NoeMrct/terrarium_thermostat/docs/depannage.md

# Dépannage — arbre de décision

Partir du symptôme, suivre les flèches. Les commandes série (`help`, `status`,
`scan`, `sante`, `journal`) se tapent dans le moniteur série de l'IDE Arduino à
115200 bauds, ou dans `arduino-cli monitor`.

```mermaid
flowchart TD
  A[Symptôme] --> B{L'écran s'allume ?}
  B -- non --> B1{LED rouge de la carte allumée ?}
  B1 -- non --> B2[Pas d'alimentation : LM2596 à 5,00 V ? fusible ? masse commune ?]
  B1 -- oui --> B3[OLED : SDA 21 / SCL 22 inversés ? adresse 0x3C ? tester `scan` i2c]
  B -- oui --> C{Que dit l'écran ?}
  C -- "AP" --> C1[Pas de Wi-Fi : réseau terrarium-config-XXXXXX, la page s'ouvre seule sinon 192.168.4.1 ; ou `wifi ssid mdp` en série, qui essaie tout de suite]
  C -- "! SONDE" --> D
  C -- "! SURCHAUFFE" --> E
  C -- "! FIGEE" --> F
  C -- "adresse IP, températures" --> G{Le problème est à distance ?}
  G -- oui --> H
  G -- non --> I[Comportement thermique : voir plus bas]
```

## D — Défaut SONDE, ou « aucune sonde détectée »

1. `scan` : combien de sondes ? Si 0, c'est le câblage 1-Wire, pas le logiciel.
2. Résistance **4,7 kΩ entre data et 3,3 V** présente ? Mesurée à 4,7 (calibre 20 k) ?
3. Data sur **GPIO4** du module lui-même — pas une borne de carte d'accueil
   non vérifiée. Mesurer picot ↔ borne à l'ohmmètre : attendu ≈ 0 Ω. (Une carte
   d'accueil a déjà montré 900 kΩ.)
4. Masse commune entre la sonde et la carte ; rouge sur 3,3 V (ou 5 V : tout
   DS18B20 accepte 3 à 5,5 V).
5. Fils Dupont : chacun testé à l'ohmmètre ; les sertissages bon marché font
   des liaisons à haute résistance.
6. Si une seule sonde : la lier aux deux zones en attendant n'est pas possible ;
   la zone sans sonde reste en défaut, c'est voulu.
7. Deux sondes détectées mais la zone reste en défaut : `identifier <zone>` (puis
   serrer sa sonde dans la main) ou `lier <index> <zone>`, puis `reset`.
8. Sonde remplacée : l'ancienne est « absente du bus » et la nouvelle n'est pas
   liée d'office (elle pourrait être celle d'une autre plaque). `identifier
   <zone>` la lie sans ambiguïté.

## E — Défaut SURCHAUFFE

- La sonde a lu plus que la coupure maximale. Si la température réelle (IR) est
  normale : sonde mal placée (contre un point très chaud), ou coupure maximale
  trop basse par rapport à la consigne.
- Si la température réelle est vraiment haute : tapis trop puissant pour la
  surface, ou MOSFET resté passant → couper le 12 V, mesurer la grille (doit être
  à 0 V tapis coupé), remplacer le MOSFET.

## F — Défaut FIGEE (sonde bloquée)

La sonde renvoie strictement la même valeur pendant des minutes. Souvent un fil
data intermittent (valeur en cache du capteur) ou une sonde contrefaite. Secouer
doucement le câble en regardant `status` : si la valeur bouge, c'est le fil.

## G — Défaut CHAUFFE SANS EFFET (sondes inversées)

La chauffe d'une zone a fait monter la sonde d'une autre zone, pas la sienne :
les sondes sont presque toujours inversées (ou posées sur la mauvaise plaque).
Les deux zones sont coupées.

1. `identifier 1`, puis serrer dans la main la sonde posée sur la plaque 1 ;
   pareil pour la zone 2. Ou intervertir les sondes physiquement.
2. `reset` pour lever les défauts.
3. `essai 1` puis `essai 2` : chaque zone chauffe seule et le socle confirme que
   c'est bien sa sonde qui monte.

## H — Problèmes à distance (application)

| Ce que montre l'application | Cause probable | Quoi faire |
|---|---|---|
| « non connecté » / erreur d'adresse | URL du broker fausse, pas en `wss://` | Tester la connexion ; adresse `wss://…:8884/mqtt` chez HiveMQ |
| « connexion refusée : identifiants » | mauvais compte broker | Compte de l'application (`appli`), pas celui du socle |
| socle **hors ligne** | socle sans Wi-Fi ou sans MQTT | Bas de l'écran (WIFI --, code MQTT, AP config) ou LED bleue (éclair par seconde : pas de Wi-Fi ; double éclair : MQTT refusé) ; `reseau` en série donne la raison ; `mqtt` réglé ? TLS 8883 ? |
| socle **silencieux** | en ligne mais ne publie plus | Wi-Fi faible (voir Santé du socle), redémarrer |
| « le socle n'a pas répondu » | commande sans réponse | identifiant du socle exact (`terraXXXXXX`) ; préfixe des sujets identique des deux côtés |
| « jeton invalide » | code d'appairage faux | 24 caractères, majuscules ; `jeton` en série |
| « mets à jour l'application » | socle plus récent que l'app | Recharger l'application (bouton « Recharger ») |
| « firmware à mettre à jour » / carte Mise à jour du firmware | socle en retard sur la dernière release | Bouton « Mettre à jour » : le socle télécharge et redémarre ; état `retour arrière` = la nouvelle image a planté, l'ancienne tourne |
| « hote non autorise » à la mise à jour | URL hors des releases du dépôt | Donner une version (`3.4.0`) plutôt qu'une URL ; un fork adapte `config.h` |
| `terraXXXXXX.local` injoignable | réseau sans mDNS, ou cookies bloqués en `http://` | Adresse IP (dans la santé du socle : `ip`) ; autoriser les cookies pour l'adresse locale |

## I — Comportement thermique

- **N'atteint pas la consigne** : alimentation déclarée trop faible (une seule
  zone à la fois), tapis sous-dimensionné, pièce froide. Regarder `demande` :
  100 % en permanence = manque de puissance.
- **Oscille** : lancer l'autotune une fois stable ; sinon bande plus large.
- **Dérive signalée** : couvercle ouvert, pièce froide, tapis vieillissant.
- **Chauffe sans effet** (alerte) : le tapis chauffe et rien ne monte. Fil de
  tapis coupé, bilame ouvert (plaque > 70 °C ?), fusible. Avec un INA219, la
  mesure de courant le dit directement. Si c'est la sonde d'une autre zone qui
  monte, c'est un défaut : voir G.
- **Trop chaud** : la zone dépasse sa consigne sans chauffer. La pièce ou une
  lampe chauffe plus que voulu : le socle ne peut que couper, c'est déjà fait.

## Après un redémarrage inattendu

`sante` affiche la cause (`PANIQUE`, `WATCHDOG`, `CHUTE D'ALIMENTATION`) et le
résumé du coredump ; `test usine` vérifie en une fois écran, sondes, mémoire,
partitions et Wi-Fi. `CHUTE D'ALIMENTATION` = le 5 V s'est effondré : LM2596,
câble, ou tapis qui tire sur le 12 V au démarrage. `PANIQUE` = bug : joindre le
fichier `/api/coredump` à un rapport. Une mise à jour fraîche qui plante est
annulée toute seule : le socle revient à la version d'avant et le dit.

Trois redémarrages anormaux de suite déclenchent une alerte : à ce stade, c'est
l'alimentation ou le câblage qu'il faut revoir avant toute chose. Après une
coupure de courant, une alerte donne sa durée (en fourchette) dès que l'heure
est revenue.
