NoeMrct/terrarium_thermostat/PROTOCOLE.md

# Protocole de pilotage à distance

Ce document décrit comment une application web ou mobile parle au socle
chauffant à travers un broker MQTT, depuis n'importe où.

---

## 1. Le principe

Le socle n'est pas joignable depuis Internet : il est derrière une box, sans
adresse publique. Il ne reçoit donc pas de connexions — **c'est lui qui se
connecte** à un broker MQTT, et il y reste attaché en permanence.

L'application fait de même. Le broker sert de point de rendez-vous entre les
deux, et personne n'a besoin d'ouvrir de port.

```
   socle ───┐                        ┌─── application web
            ├──►  broker MQTT  ◄─────┤
   socle ───┘   (rendez-vous)        └─── application mobile
```

**L'historique reste sur le socle.** Le broker ne transporte que l'état courant,
les événements et les commandes. C'est ce choix qui rend l'ensemble tenable sur
un hébergement gratuit : quelques kilo-octets par appareil et par jour, au lieu
de plusieurs méga-octets si l'on remontait chaque point de mesure.

---

## 2. Le code d'appairage

À son tout premier démarrage, le socle tire au sort un code de 24 caractères
avec le générateur aléatoire matériel de l'ESP32, l'enregistre, et **l'affiche
en grand à l'écran pendant vingt secondes**. Il est aussi écrit sur le port
série.

```
Code d'appairage : K7M2QX-4TBW9H-RPFZ3N-XCVJ8D
```

Ce code est retrouvable à tout moment :

- commande série `jeton` (il se réaffiche aussi à l'écran) ;
- onglet Réseau de l'interface web locale ;
- `jeton nouveau` en génère un autre — les applications déjà appairées devront
  alors être réappairées.

Il vaut **preuve de propriété** : quiconque le possède peut piloter le socle. Il
n'est jamais transmis en clair sur le réseau tant que MQTT est chiffré.

Pour un produit, l'imprimer sous forme de QR code collé sous l'appareil évite à
l'acheteur d'avoir à le recopier.

---

## 3. Configuration du socle

```
mqtt broker.exemple.fr 8883 utilisateur motdepasse
mqtt tls on
redemarrer
```

Vérifier ensuite avec `reseau`. Le socle publie son état dès qu'il change (au
plus toutes les 2 s, au moins toutes les 60 s) et se reconnecte tout seul. Avec
le serveur Terrariums (`serveur/`), `outils/provisionner.js` crée le compte du
socle et passe cette commande à sa place.

Tout cela se règle aussi depuis l'onglet Réseau de l'interface web.

---

## 4. Les sujets MQTT

Avec un préfixe `terrarium` et un identifiant d'appareil `terraA1B2C3` :

| Sujet | Sens | Contenu |
|---|---|---|
| `terrarium/terraA1B2C3/statut` | socle → app | `en ligne` / `hors ligne` (persistant) |
| `terrarium/terraA1B2C3/zone1/etat` | socle → app | JSON d'état (persistant), **dès que quelque chose change** — au plus toutes les 2 s — et de toute façon toutes les 60 s ; depuis la 3.5, avec `autotune`, `derive` et `trop_chaud` (`"0"`/`"1"`) |
| `terrarium/terraA1B2C3/zone2/etat` | socle → app | idem |
| `terrarium/terraA1B2C3/sante` | socle → app | JSON de santé (persistant), toutes les 60 s : `proto`, `version`, `uptime`, `rssi`, `heap`, `heapMin`, `blocMax`, `reset`, `otaEnAttente`, `signatureOta`, `hote` (`terraA1B2C3.local`), `ip`, `maj` (dernière mise à jour tirée : `etape`, `version`, `detail` — absent si aucune), `plantage` (si un coredump existe), `courantA`/`energieWh` (avec INA219), `mqtt` (état de la connexion au broker, en clair) et `webProtege` (l'interface locale demande un mot de passe), depuis la 3.5 |
| `terrarium/terraA1B2C3/rapport` | socle → app | rapport quotidien en texte (persistant), à l'heure choisie, si le rapport est activé — depuis la 3.5 |
| `terrarium/terraA1B2C3/maj` | socle → app | progression d'une mise à jour tirée (non persistant) : `etat` (`telechargement`, `redemarrage`, `erreur`), `pct`, `detail`, `version` |
| `terrarium/terraA1B2C3/cmd` | app → socle | requête JSON (l'application l'envoie en QoS 1) |
| `terrarium/terraA1B2C3/reponse` | socle → app | réponse JSON |
| `terrarium/serveur` | serveur → app | **serveur Terrariums seulement** : annonce retenue `{"serveur":"terrariums","version":…,"push":…}`, lisible par tout compte, que lui seul écrit. Un socle n'y touche jamais ; un broker nu n'a pas ce sujet, et l'application n'y attend rien |

Le sujet `statut` utilise le **testament** MQTT : si le socle disparaît
brutalement (coupure de courant, WiFi perdu), le broker publie lui-même
`hors ligne`. L'application le sait en quelques secondes, sans rien interroger.
Un socle `en ligne` qui n'a rien publié depuis plus de deux minutes est montré
**silencieux** par l'application : le testament ne distingue pas un socle vivant
d'un socle coincé.

### Version du protocole

Le socle annonce `proto` (dans `sante`, dans la réponse `etat` et `version`).
Cette page décrit la **version 4** (firmware 3.5) : les commandes modifiantes
voyagent signées, sans le code d'appairage en clair (voir « Commandes
signées » ci-dessous), et l'application fait à distance ce que seule la page
locale savait faire (sondes, essai, calibration, rapport, journal, résumés
journaliers, sauvegarde, surveillance — dernières lignes du tableau des
actions). La version 3 (3.4) a ajouté l'action `maj`, le sujet
`maj` et les champs `hote`, `ip`, `maj` de la santé. La version 2
(3.3) n'avait pas de mise à jour tirée ; la version 1 (3.0 à 3.2) n'avait ni
`sante`, ni `proto`, ni le rejeu des commandes. Un changement que
l'application ne saurait pas interpréter incrémente ce numéro ; l'application
affiche « mets à jour l'application » ou « firmware à mettre à jour » selon le
cas. `protocole.schema.json` (JSON Schema) décrit formellement chaque message,
et `outils/test-protocole.js` vérifie que tout ce que le socle émet s'y conforme.

---

## 5. Le canal de commande

Une seule paire de sujets transporte tout, en JSON. La surface exposée est celle
de l'interface web locale.

### Requête

```json
{ "req": "42", "action": "zone", "jeton": "K7M2QX...", "z": 0, "jour": 32.5 }
```

- `req` : identifiant libre (23 caractères au plus), recopié dans la réponse pour
  l'apparier. **Une requête déjà traitée reçoit à nouveau sa réponse sans être
  rejouée** : le socle garde ses huit dernières réponses courtes. C'est ce qui
  permet d'envoyer les commandes en QoS 1 (livraison garantie, doublons
  possibles) sans qu'un `redemarrer` redémarre deux fois.
- `action` : voir le tableau ci-dessous.
- `jeton` : exigé pour toute action modifiante d'un socle d'avant le protocole
  4. Les actions de lecture s'en passent. Un socle au protocole 4 l'accepte
  encore, mais l'application ne l'envoie plus : elle signe.

### Commandes signées (protocole 4)

Le code d'appairage ne circule plus sur le broker. La commande est sérialisée
telle quelle, horodatée, puis mise dans une enveloppe avec sa signature :

```json
{ "c": "{\"req\":\"42\",\"action\":\"zone\",\"z\":0,\"jour\":32.5,\"ts\":1794600000}",
  "sig": "<HMAC-SHA256 de c, clé = code d'appairage, 64 chiffres hexadécimaux minuscules>" }
```

- La signature porte sur les octets UTF-8 exacts de `c` : rien à
  canonicaliser, le socle vérifie puis relit `c` comme une requête ordinaire.
- `ts` (secondes Unix) : un socle à l'heure refuse une commande signée qui
  s'en écarte de plus de 5 minutes (`commande perimee`) ; c'est ce qui borne le
  rejeu d'une commande captée, avec la mémoire des huit dernières requêtes.
- Signature fausse : `{"ok":false,"erreur":"signature invalide"}` (avec le
  `req` de la commande), journalisé comme un code refusé.
- En JavaScript : `crypto.subtle.importKey('raw', code, {name: 'HMAC', hash:
  'SHA-256'}, …)` puis `sign('HMAC', clé, c)` ; en Node : `crypto.createHmac`.

### Réponse

```json
{ "req": "42", "ok": true }
{ "req": "42", "ok": false, "erreur": "Consigne de jour hors 10-45 C" }
```

### Actions disponibles

| Action | Jeton | Paramètres | Effet |
|---|---|---|---|
| `etat` | non | — | Températures, consignes du moment **et de référence**, demande, charge, défauts, autotune, dérive, horaires, temps de fonctionnement, `proto` et `sante` |
| `version` | non | — | Version du firmware, date de compilation, `proto` |
| `stats` | non | — | Min / max / moyenne sur 24 h, temps hors plage, énergie, compteurs de défauts |
| `historique` | non | `heures` (1-400, défaut 24), `max` (1-200, défaut 120) | Points de courbe, échantillonnés |
| `zone` | **oui** | `z`, et `nom`, `jour`, `nuit`, `bande`, `ki`, `max`, `offset`, `rampe`, `debutJour`, `debutNuit`, `deriveSeuil`, `deriveMin`, `inefficaceMin`, `inefficaceDelta`, `chuteSeuil`, `chuteSecondes` | Modifie une zone |
| `globaux` | **oui** | aucun (lecture), ou `amperes`, `watts`, `volts`, `entretienMin`, `ecranVeilleMin`, `saisonActive`, `saisonDelta`, `saisonDescenteJ`, `saisonPlateauJ`, `saisonRemonteeJ` ; depuis le protocole 4 : `prixKwh` (0-5 €), `rapportActif`, `rapportMinutes` (heure d'envoi, 0-1439), `ledEteinte`, `ecranNuit` (0 atténué, 1 normal, 2 éteint), `soleilActif`, `soleilDecalageMin` (-180-180), `latitude` (-65-65), `longitude`, `zonePrioritaire` (0 aucune, 1 ou 2) | Lit ou modifie les réglages de l'appareil |
| `reset` | **oui** | — | Lève les défauts verrouillés |
| `entretien` | **oui** | `minutes` (0-240, 0 annule) | Coupe le chauffage temporairement, reprise automatique |
| `autotune` | **oui** | `z` | Lance la calibration automatique |
| `stop-autotune` | **oui** | `z` | L'interrompt |
| `effacer-historique` | **oui** | — | Vide les courbes |
| `alim` | **oui** | `amperes`, `watts` | Raccourci historique de `globaux` |
| `redemarrer` | **oui** | — | Redémarre le socle |
| `maj` | **oui** | `version` (`X.Y.Z`, release GitHub) ou `url` (`https://`, releases du dépôt seulement), `forcer` | Le socle télécharge et installe l'image, publie sa progression sur `maj`, redémarre ; la réponse `{"ok":true,"maj":"telechargement"}` part avant le téléchargement. Refus : `deja en X.Y.Z` (sans `forcer`), `hote non autorise`, `hors ligne` |
| `sondes` | **oui** | `relire` (relit le bus 1-Wire d'abord) | `"sondes":{…}` : les sondes du bus (`rom`, `temp`, `zone` comptée depuis 0, -1 si libre), `liaisons` de chaque zone (`rom`, `presente`), `identification` en cours, `resultat` de la dernière |
| `lier` | **oui** | `z`, `rom` (16 chiffres hexadécimaux) | Lie une sonde présente à une zone (et la retire d'une autre) ; `message` |
| `identifier` / `stop-identifier` | **oui** | `z` / — | Lance l'assistant (chauffe suspendue, 2 min au plus : la sonde qu'on serre dans la main se lie à la zone) ou l'annule ; l'avancement se lit avec `sondes` |
| `essai` / `stop-essai` | **oui** | `z` / — | Essai de chauffe d'une zone seule ; sans `z`, `"essai":{"zone","restantS","resultat"}` (`zone` comptée depuis 1, 0 : aucun essai) |
| `calibrer` | **oui** | — | Aligne la zone 2 sur la zone 1 (sondes côte à côte) ; `message` ou `erreur` |
| `rapport` | **oui** | `envoyer` | Le rapport du jour (`texte`), ou son envoi immédiat vers l'adresse des alertes |
| `jours` | **oui** | `n` (1-400, défaut 7) | `"jours":{"prixKwh","jours":[…]}` : résumés journaliers du plus récent au plus ancien, autant qu'un message en tient (une trentaine) ; la page locale les donne tous |
| `journal` | **oui** | — | La fin du journal (`texte`, 5000 caractères au plus) |
| `sauvegarde` | **oui** | — | `"sauvegarde":{…}` : la configuration (zones, réglages, sondes, réseau non secret), **sans les adresses d'alerte et de heartbeat** |
| `restaurer` | **oui** | `sauvegarde` (objet) | Réapplique une sauvegarde, tout ou rien ; les adresses absentes gardent celles du socle ; `message` |
| `reseau` | **oui** | aucun (lecture), ou `urlAlertes`, `urlHeartbeat` (`http(s)://`, 160 car.), `heartbeatMinutes` (1-1440), `formatAlertes` (0 JSON, 1 texte) | La surveillance seulement. Réponse : `ssid`, `ssid2`, `alertes` et `heartbeat` (**l'hôte seul** des adresses, vide si aucune), `heartbeatMinutes`, `formatAlertes`. Tout identifiant Wi-Fi (`ssid`, `ssid2`, `wifiPass`, `wifiPass2`) est refusé : le Wi-Fi se règle sur la page locale |

Les horaires (`debutJour`, `debutNuit`) sont en minutes depuis minuit :
`8:00` s'écrit `480`.

### Format de l'historique

Un message MQTT n'a pas de tampon extensible, contrairement à une réponse HTTP
diffusée par morceaux. Les points sont donc renvoyés **compactés**, sous forme de
tableaux plutôt que d'objets — une clé par valeur aurait triplé la taille :

```json
{
  "req": "42", "ok": true,
  "format": ["epoch", "t1", "consigne1", "t2", "consigne2"],
  "unite": "centiemes de degre",
  "pas": 12, "heures": 24, "n": 120,
  "points": [[1757520000, 3205, 3200, 2790, 2800], [1757520720, null, 3200, 2788, 2800]]
}
```

`null` marque une mesure absente. `pas` dit combien de points d'origine sépare
deux points renvoyés. **L'historique complet reste sur le socle** : ce canal n'en
transporte qu'un échantillonnage, à la demande.

### Validation

Les réglages passent **exactement les mêmes contrôles** que par l'interface
web ou la console série : la validation vit dans le cœur de régulation, elle
n'est pas réécrite pour chaque interface. Une application ne peut donc pas
placer le socle dans un état que l'interface locale refuserait.

---

## 6. Exemple d'application

```js
import mqtt from 'mqtt';

const ID = 'terraA1B2C3';
const JETON = 'K7M2QX...';
const base = `terrarium/${ID}`;

const client = mqtt.connect('wss://broker.exemple.fr:8884/mqtt', {
  username: 'app', password: '…'
});

client.on('connect', () => {
  // Attention : le joker occupe un niveau entier, « zone+/etat » est invalide.
  client.subscribe([`${base}/statut`, `${base}/+/etat`, `${base}/reponse`]);
});

client.on('message', (sujet, charge) => {
  if (sujet.endsWith('/statut')) {
    majPresence(charge.toString() === 'en ligne');
  } else if (sujet.endsWith('/etat')) {
    majZone(sujet, JSON.parse(charge));
  } else if (sujet.endsWith('/reponse')) {
    const r = JSON.parse(charge);
    (attentes[r.req] || (() => {}))(r);
    delete attentes[r.req];
  }
});

const attentes = {};
// Protocole 4 : la commande part signée, le code ne quitte pas l'application.
async function signer(c) {
  const enc = new TextEncoder();
  const cle = await crypto.subtle.importKey('raw', enc.encode(JETON), { name: 'HMAC', hash: 'SHA-256' }, false, ['sign']);
  const mac = new Uint8Array(await crypto.subtle.sign('HMAC', cle, enc.encode(c)));
  return Array.from(mac, x => x.toString(16).padStart(2, '0')).join('');
}

function commander(action, params = {}) {
  return new Promise(async (resoudre, rejeter) => {
    const req = String(Date.now());
    attentes[req] = r => (r.ok ? resoudre(r) : rejeter(new Error(r.erreur)));
    const c = JSON.stringify({ req, action, ts: Math.floor(Date.now() / 1000), ...params });
    client.publish(`${base}/cmd`, JSON.stringify({ c, sig: await signer(c) }));
    setTimeout(() => {
      if (attentes[req]) { delete attentes[req]; rejeter(new Error('pas de reponse')); }
    }, 8000);
  });
}

// Passer la zone 1 à 32,5 °C le jour
await commander('zone', { z: 0, jour: 32.5 });

// Douze heures de courbe, 60 points au plus
const h = await commander('historique', { heures: 12, max: 60 });
const releves = h.points.map(([t, t1, c1]) => ({
  date: new Date(t * 1000),
  temperature: t1 === null ? null : t1 / 100,
  consigne:    c1 === null ? null : c1 / 100
}));

// Déclarer une alimentation plus grosse
const g = await commander('globaux', { amperes: 5 });
console.log(`${g.zonesSimultanees} zone(s) peuvent chauffer en même temps`);
```

**Le délai d'attente n'est pas facultatif** : un socle hors ligne ne répond pas,
et l'application doit le présenter comme tel plutôt que de rester bloquée.

---

## 7. Sécurité

| Mécanisme | Ce qu'il protège |
|---|---|
| MQTT chiffré (TLS) | Personne ne lit ni ne modifie le trafic en chemin |
| Certificats vérifiés (activé d'usine) | Personne ne se fait passer pour ton broker |
| Identifiants par appareil sur le broker | Un socle compromis ne donne pas accès aux autres |
| Jeton exigé pour les actions modifiantes | Un broker mal cloisonné ne suffit pas à piloter un socle |
| Commandes signées et horodatées (protocole 4) | Qui lit le broker ne vole pas le code d'appairage ; il ne peut ni forger une commande ni en rejouer une ancienne |
| Aucun secret relu par le broker (protocole 4) | Ni mot de passe Wi-Fi (refusé dans `reseau`), ni adresse d'alerte ou de heartbeat (seul l'hôte revient, la sauvegarde les omet) : lire le broker ne donne pas de quoi entrer sur le réseau ni écrire dans tes notifications |
| Validation dans le cœur de régulation | Aucune commande ne peut créer un réglage dangereux |
| OTA réseau désactivée sans mot de passe | Personne sur le réseau local ne réécrit le firmware |
| Images signées (ECDSA P-256) exigées par `/api/maj` et par la mise à jour tirée quand une clé publique est compilée | Même avec le mot de passe de l'interface ou le jeton, pas de firmware étranger |
| Mise à jour tirée limitée aux releases du dépôt (HTTPS, certificat vérifié, redirections bornées aux serveurs de GitHub) | Un jeton volé ne fait pas charger un binaire hébergé ailleurs |
| Interface locale : connexion par défi/réponse, session `HttpOnly` 24 h, pause après cinq échecs | Le mot de passe ne circule pas, et ne se devine pas en boucle |
| Retour arrière automatique après une mise à jour | Une image qui plante ne prive pas le terrarium de régulation |
| Commandes rejouées sans effet | Un doublon livré par le broker (QoS 1) n'agit pas deux fois |

**À faire côté broker** : un compte par appareil, avec des droits limités à ses
propres sujets. Sans ce cloisonnement, un appareil compromis pourrait écouter et
commander tous les autres — le jeton limite les dégâts, mais ne remplace pas un
cloisonnement correct.

**Ce que le jeton ne protège pas** : les actions de lecture (`etat`, `version`,
`stats`, `historique`) s'en passent délibérément, pour qu'un tableau de bord de
supervision puisse afficher l'état sans détenir de quoi modifier quoi que ce
soit. Quiconque peut s'abonner aux sujets du socle voit donc ses températures.
Si cela pose problème, c'est au cloisonnement du broker de le régler.

---

## 8. Ce que le socle continue de faire sans réseau

C'est le point le plus important pour un produit dont dépend un animal vivant.

Broker injoignable, WiFi coupé, serveur éteint : **la régulation continue à
l'identique**. Les consignes, le cycle jour/nuit, les diagnostics, les coupures
de sécurité et l'historique fonctionnent en local. L'écran affiche tout, la
console série pilote tout, et l'interface web reste accessible sur le réseau
local.

Le réseau n'ajoute que la commodité : accès de loin, alertes, courbes sur le
téléphone. Il ne conditionne jamais la sécurité de l'animal, et aucune évolution
future ne doit changer cela.
