NoeMrct/terrarium_thermostat/outils/references-visuelles/desktop-sombre-appareil.png

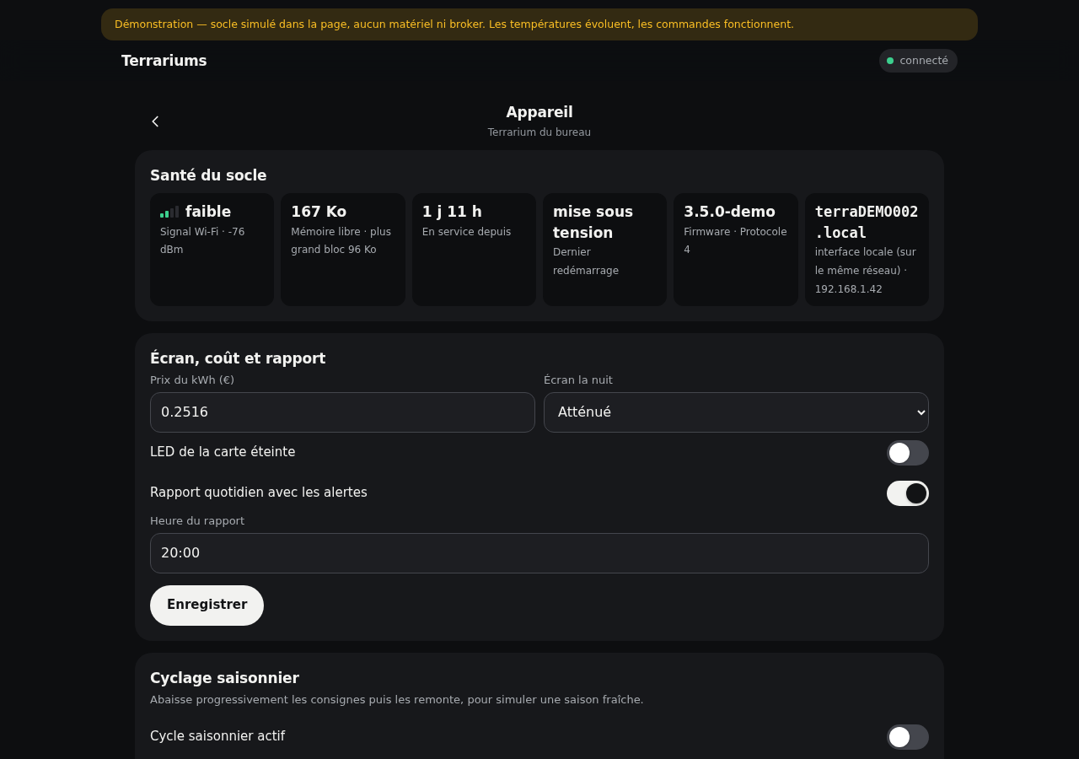
outils/references-visuelles/desktop-sombre-appareil.png
