NoeMrct/terrarium_thermostat/outils/references-visuelles/desktop-sombre-bienvenue.png

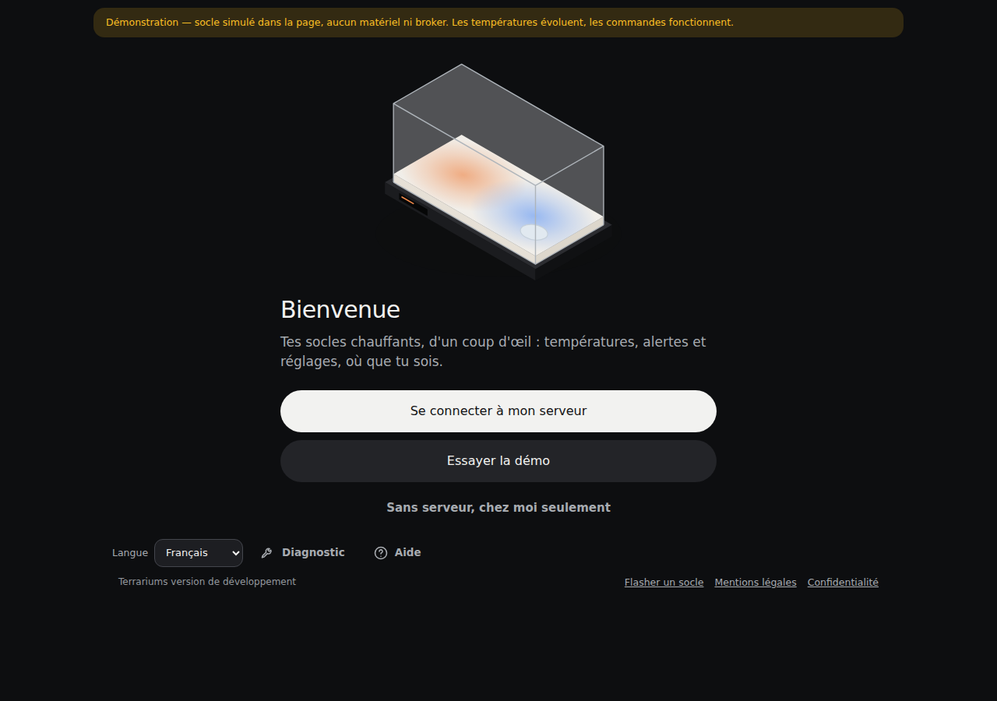
outils/references-visuelles/desktop-sombre-bienvenue.png
