NoeMrct/terrarium_thermostat/outils/references-visuelles/desktop-sombre-courbes.png

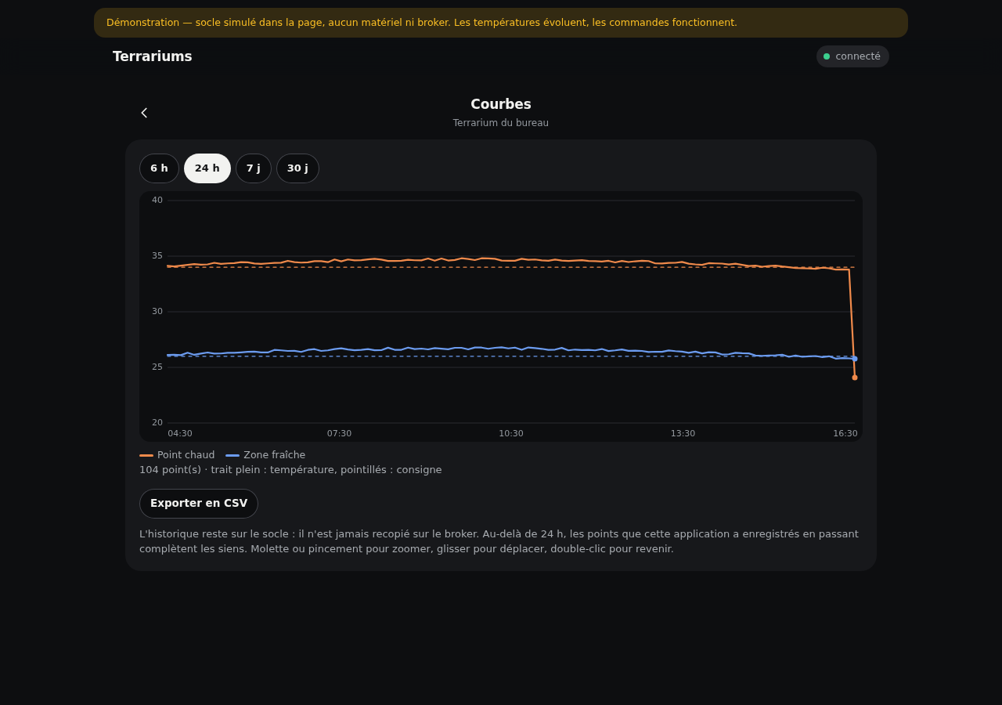
outils/references-visuelles/desktop-sombre-courbes.png
