NoeMrct/terrarium_thermostat/outils/references-visuelles/desktop-sombre-etat.png

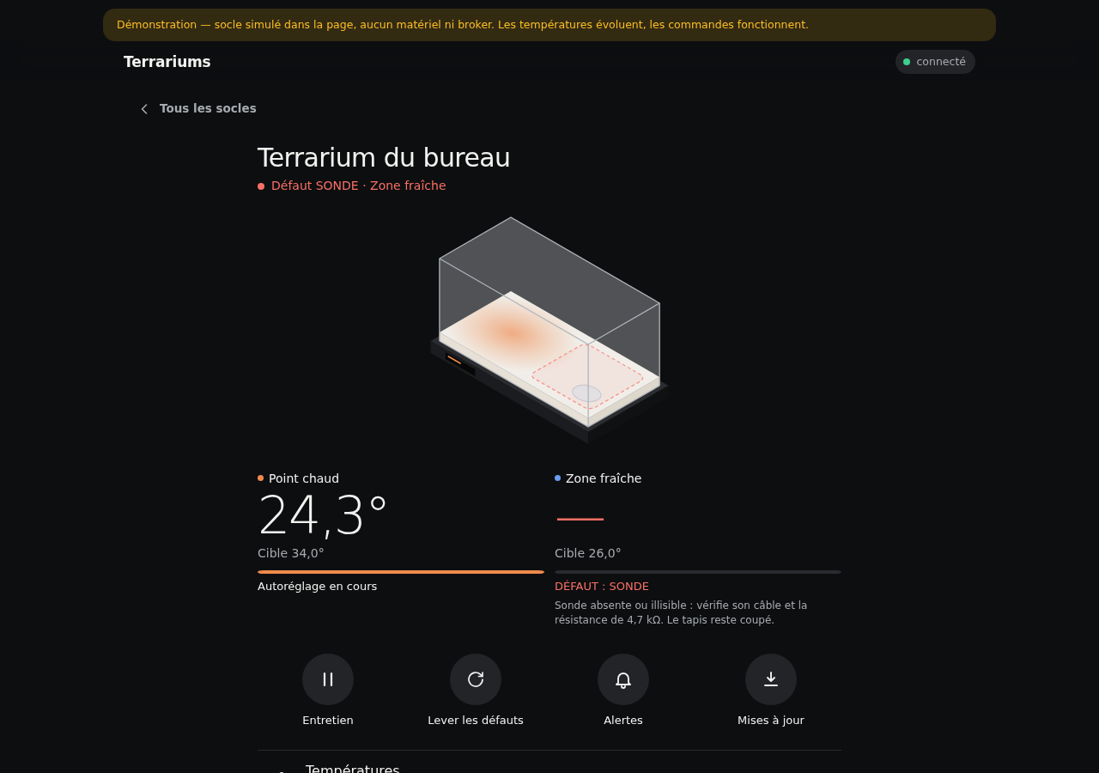
outils/references-visuelles/desktop-sombre-etat.png
