NoeMrct/terrarium_thermostat/outils/references-visuelles/desktop-sombre-liste.png

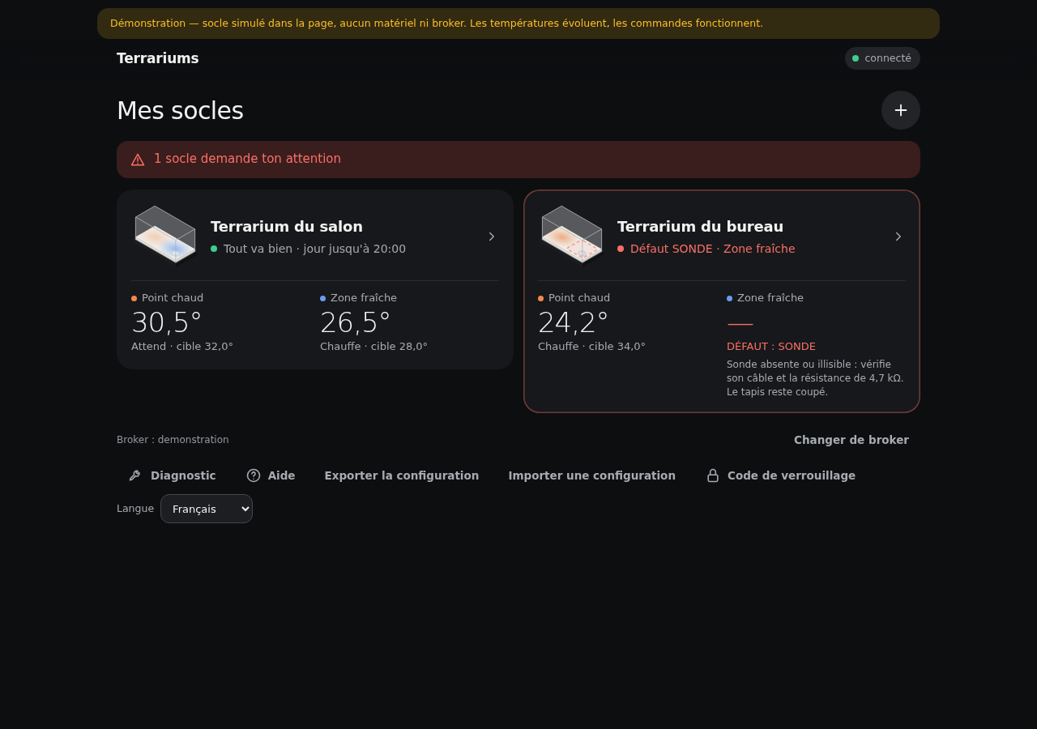
outils/references-visuelles/desktop-sombre-liste.png
