NoeMrct/terrarium_thermostat/outils/references-visuelles/desktop-sombre-reglages.png

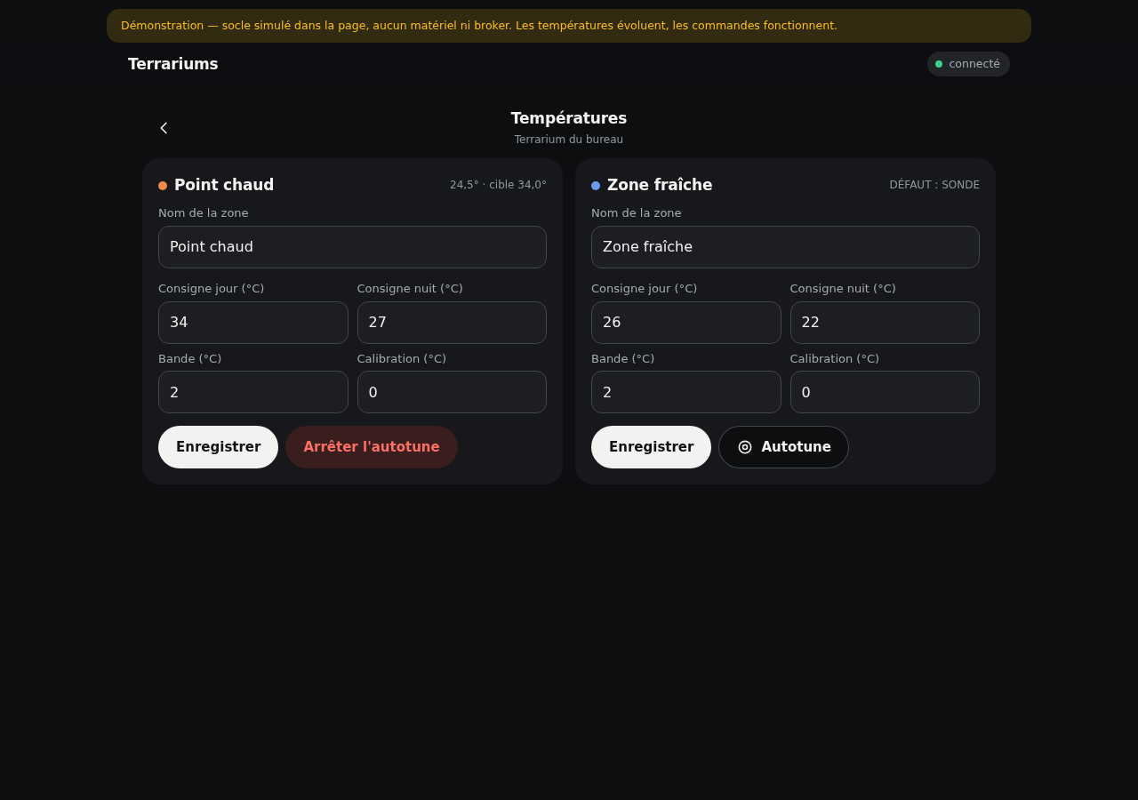
outils/references-visuelles/desktop-sombre-reglages.png
