NoeMrct/terrarium_thermostat/outils/references-visuelles/desktop-sombre-verrou.png

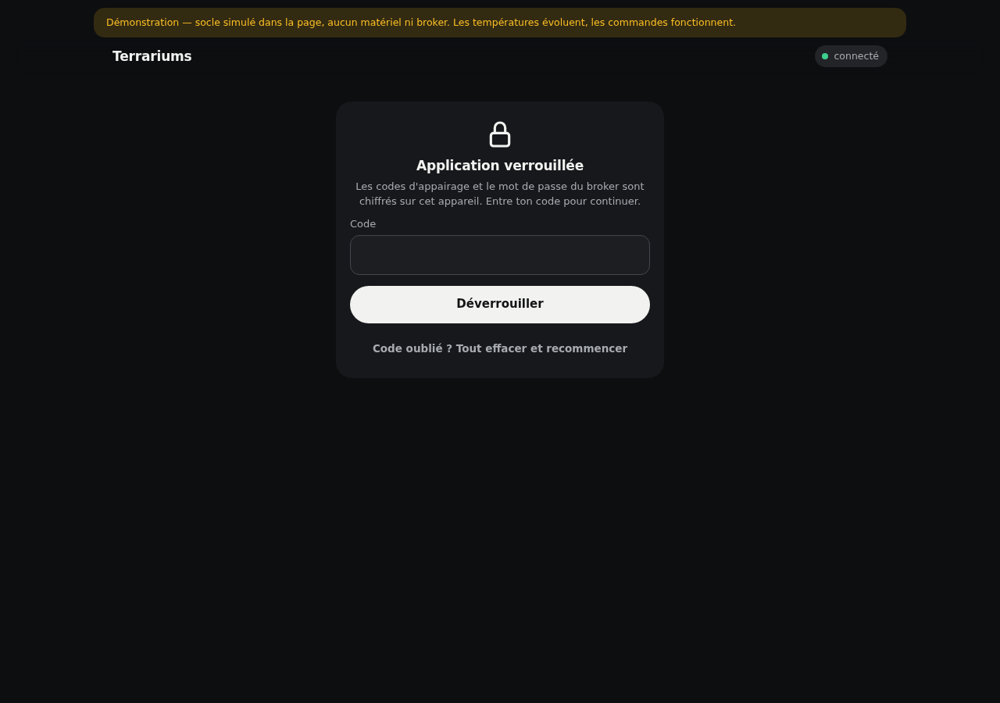
outils/references-visuelles/desktop-sombre-verrou.png
