NoeMrct/terrarium_thermostat/outils/references-visuelles/desktop-sombre-zone.png

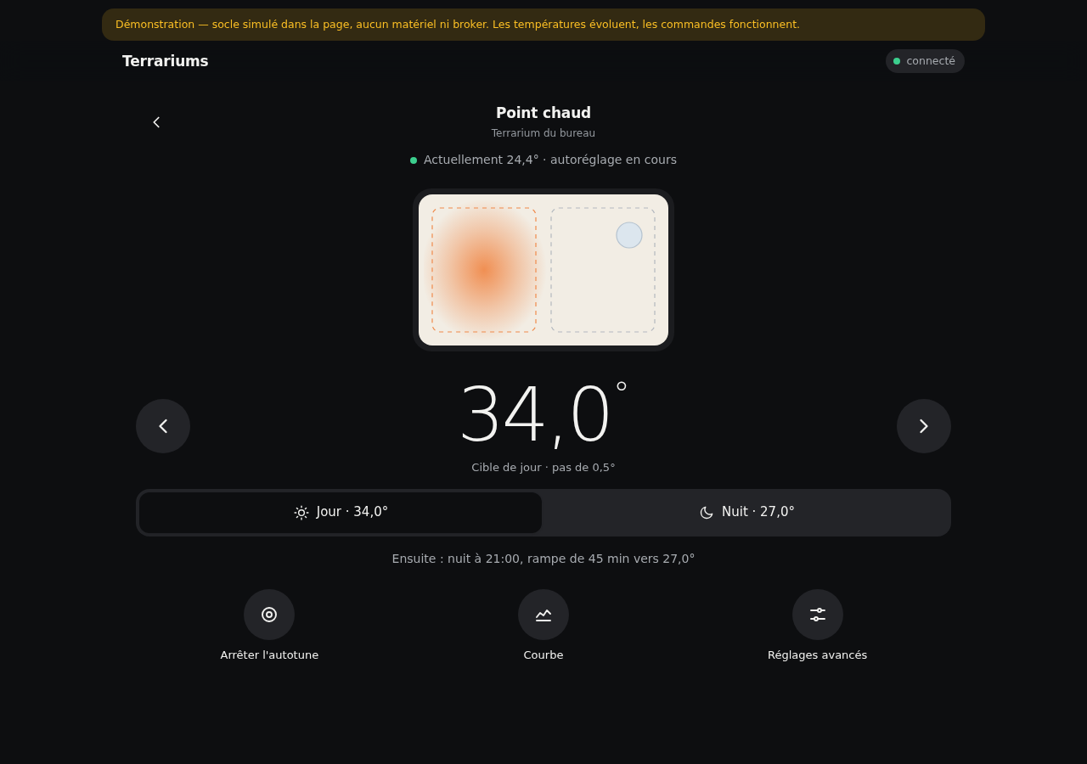
outils/references-visuelles/desktop-sombre-zone.png
