NoeMrct/terrarium_thermostat/outils/references-visuelles/mobile-clair-appareil.png

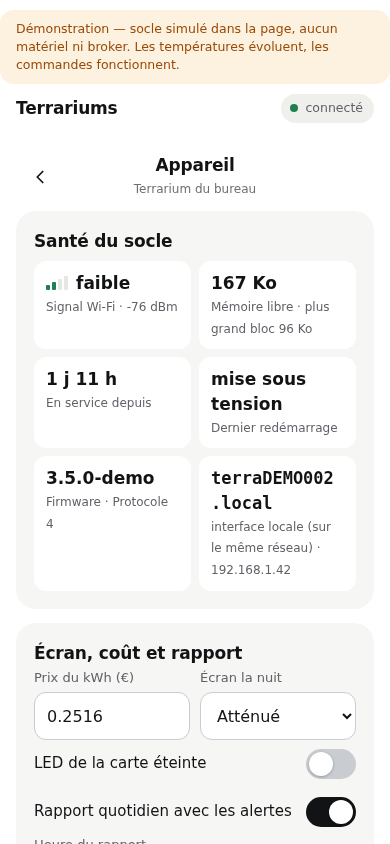
outils/references-visuelles/mobile-clair-appareil.png
