NoeMrct/terrarium_thermostat/outils/references-visuelles/mobile-clair-bienvenue.png

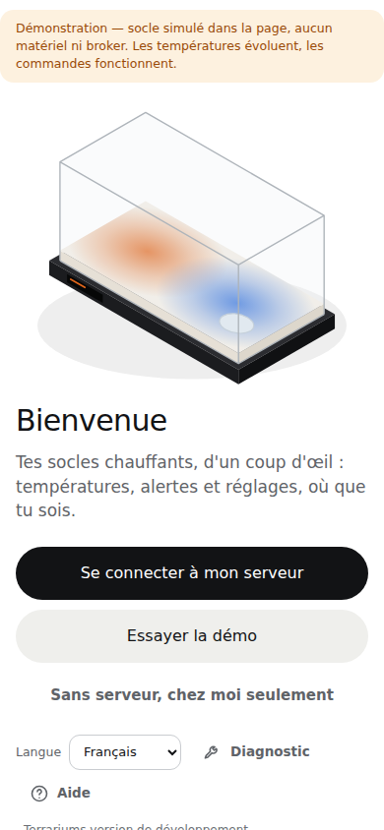
outils/references-visuelles/mobile-clair-bienvenue.png
