NoeMrct/terrarium_thermostat/outils/references-visuelles/mobile-clair-courbes.png

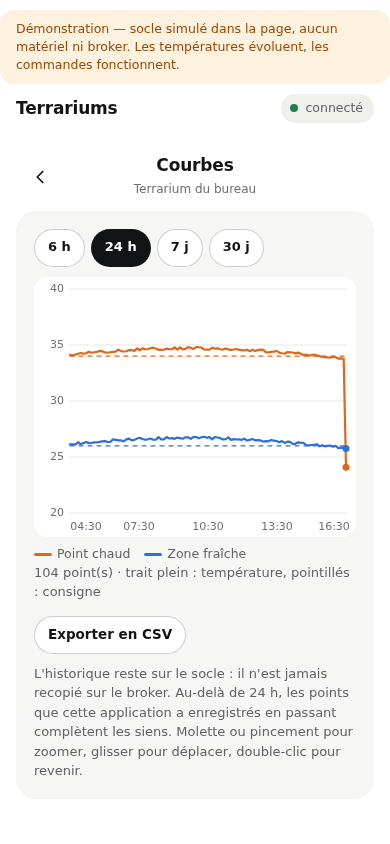
outils/references-visuelles/mobile-clair-courbes.png
