NoeMrct/terrarium_thermostat/outils/references-visuelles/mobile-clair-etat.png

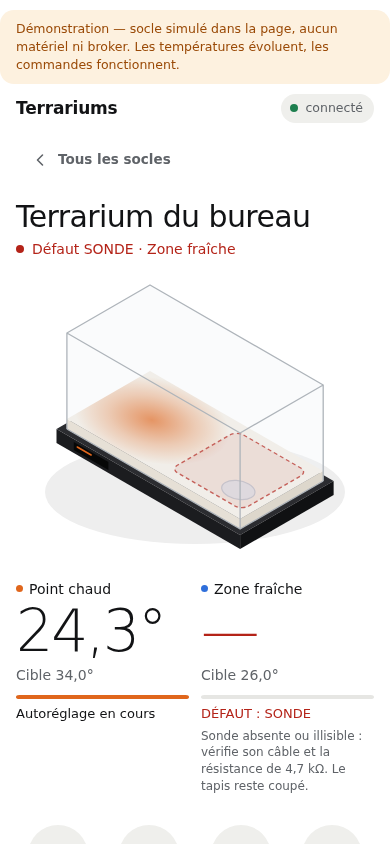
outils/references-visuelles/mobile-clair-etat.png
