NoeMrct/terrarium_thermostat/outils/references-visuelles/mobile-clair-liste.png

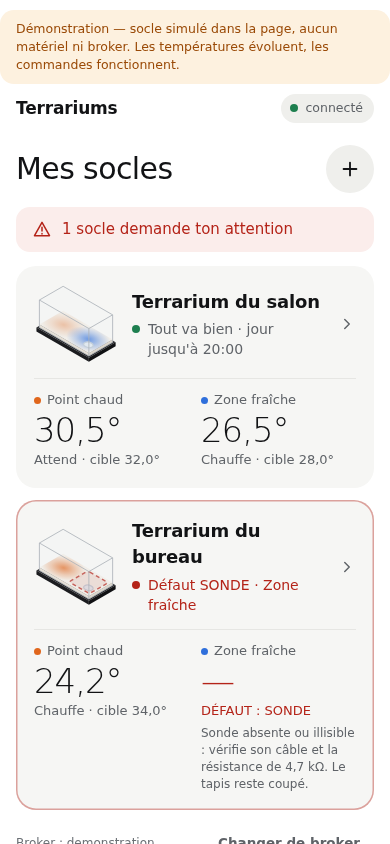
outils/references-visuelles/mobile-clair-liste.png
