NoeMrct/terrarium_thermostat/outils/references-visuelles/mobile-clair-reglages.png

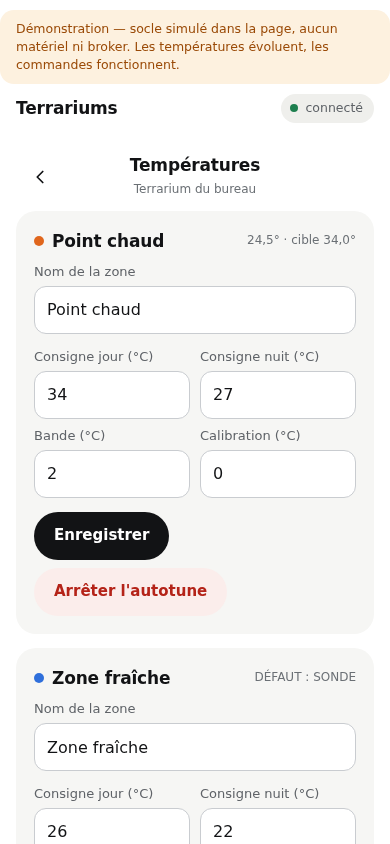
outils/references-visuelles/mobile-clair-reglages.png
