NoeMrct/terrarium_thermostat/outils/references-visuelles/mobile-clair-verrou.png

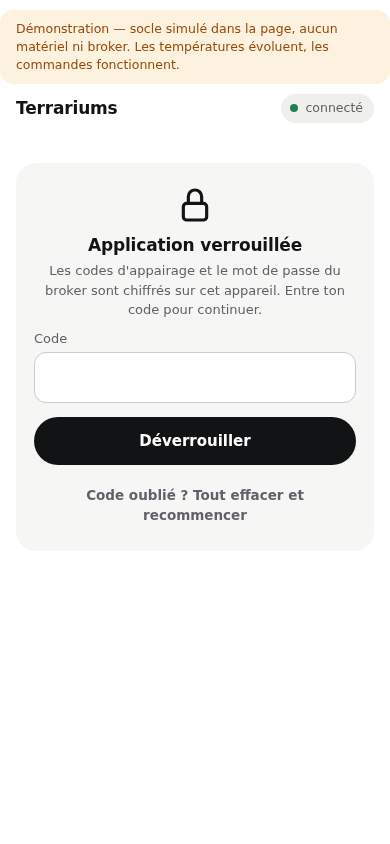
outils/references-visuelles/mobile-clair-verrou.png
