NoeMrct/terrarium_thermostat/outils/references-visuelles/mobile-clair-zone.png

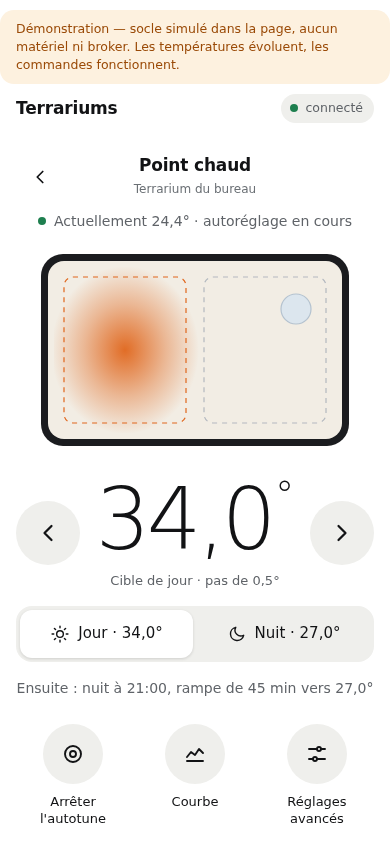
outils/references-visuelles/mobile-clair-zone.png
