NoeMrct/terrarium_thermostat/app/installateur/LISEZMOI.md

# ESP Web Tools 10.4.0 — copie servie par le site

Ces fichiers sont la distribution `dist/web/` du paquet npm `esp-web-tools`
version 10.4.0 (licence Apache-2.0, voir LICENSE), copiée telle quelle. Elle fait
tourner la page `/installer.html` : flasher un socle depuis le navigateur par
USB (Web Serial), sans IDE Arduino.

Pourquoi une copie plutôt qu'un CDN : la politique de sécurité du site
n'autorise que ses propres scripts, et une page de flashage qui chargerait du
code depuis un tiers serait exactement ce qu'il faut éviter.

Mise à jour :

    npm pack esp-web-tools@<version>
    tar -xzf esp-web-tools-<version>.tgz
    cp package/dist/web/* app/installateur/ && cp package/LICENSE app/installateur/
    sha256sum app/installateur/*.js        # puis recopier les sommes ci-dessous

`outils/verifier-installateur.js` compare les sommes ci-dessous aux fichiers :
une modification silencieuse de ce code (un dépôt compromis, une fausse
manipulation) fait échouer la vérification.

## Sommes SHA-256

```
ec2dd4fca5b46a9655b153312d2d1183b2a7fbaec4073955839a4a0432df04d0  esp32-DNPRK0Ay.js
46daa5633a1088e35b1185f046e1fa0612f163391f2be9f4f2ba51d24ee1e7ae  esp32c2-CQ3ns5Nm.js
814afa136c90d2645e9094d0a4ab78dd00ccbd622e5e635c238d86023818d00b  esp32c3-2tchr35W.js
796a1a410b8bfffefa6068b2f78fdd547542d9b8d45d1338bfb1125bb804e395  esp32c5-CeCSizBL.js
ac8db86eb42c223fe47d3e74e5d03422eb9a45cc54d31df18a5bb2f38c28048e  esp32c6-DolpfL0e.js
c1090dce2ed0ac6909945ec1cdf73ee199821b592e9c748f28c0b029baf1cc60  esp32c61-C8HktcOt.js
e7c3be1c07192fa678a46eea6d480e8c5a73098c1cceaa4097ef3c44052e9594  esp32h2-L0n5WuSo.js
7648a93d8edcfb3898aad0799c8103c8f855f088b7cb2d3dc1415a14392f3d29  esp32p4-MR0ikcda.js
5b0c5ca43181096c044ce6280fc9cf616e161e566390ba10997c5a6cc97d53c4  esp32s2-w9SUkb7o.js
6a874d98e77dba5602100660c1c0cf1d3b3e6c0bc7b07ce3959d77c6106cef66  esp32s3-DQt_R3ZE.js
1967f0ef76d492c982284c15c48f5c5022a37137786bc16a1e2d012cf69a2166  index-Dt9w-IG1.js
46128e030adf46ce3876ac28ca2103ee842cc50526e49409e8430e3b4c795f79  install-button.js
6dcfc30fb4bbf18e19a141c5eb9a694edafc5d4480b45762c221173f47effdb5  install-dialog-im156JnI.js
57581b04181316599594acb500b7a36316e9861f244508fb3c9efe0ccad9f27e  stub_flasher_32-BLbsWvxO.js
dae20b50bc4b5d54982204fd86f7aace42c8e2a0953938e0fe3516fc544a4cd2  stub_flasher_32c2-wLQhZItC.js
3f37f501942572fdec58c8cc3550ad558c931a9469b3e65fb88c9b016c1a39a7  stub_flasher_32c3-DmSvHQKL.js
221fa5ffb15094c439ee4dcb53157b3f7cd1dec7383297a6185b1d1b5cd60a9f  stub_flasher_32c5-D1WK4DyB.js
8c936767aafb82e5e1e61cc965ace311f89182b1335737f1cd3bf2ac7573f014  stub_flasher_32c6-ZuxjUVr4.js
7720d8b83e696520fa80e46829b0e5aa6ea88596dee6d448a5b1d8d8fef55715  stub_flasher_32c61-DeKkw9vN.js
a6724fc931e0bb9153c9b104cfe128b66ab0e71e405c10d529951debb31387d8  stub_flasher_32h2-CZ4EIL3w.js
fcf4cb2317525fd942210df8be84064b631ffe208f11aec81b53c8ccb6e359e2  stub_flasher_32p4-CpHBYEwI.js
d032d82b4188867dd2951b1f02bd5bcf8a7669e16184bbda87b67b757d7ec352  stub_flasher_32p4rc1-DyGqUAeZ.js
61bf5c06933184007050bb9fa6c93d0577e42208b5212cda7e806ac614b0e14a  stub_flasher_32s2-CrsP1231.js
7c05cb1dc75da8ebca5199e53de474e037f82ce5bf1978330a35354e40e87494  stub_flasher_32s3-CiJyd6Fk.js
7ca214be908aacff37fd937188f55042c9aeae8af30da7141d634ef68778fc79  stub_flasher_8266-CQFcqJ_a.js
ad32b41ad8507aed4f7241178d9a472457355ecf0282faaa655de3ea37809c9a  styles-sT2V1cOw.js
```
