NoeMrct/terrarium_thermostat/outils/references-visuelles/desktop-sombre-installation-reglages.png

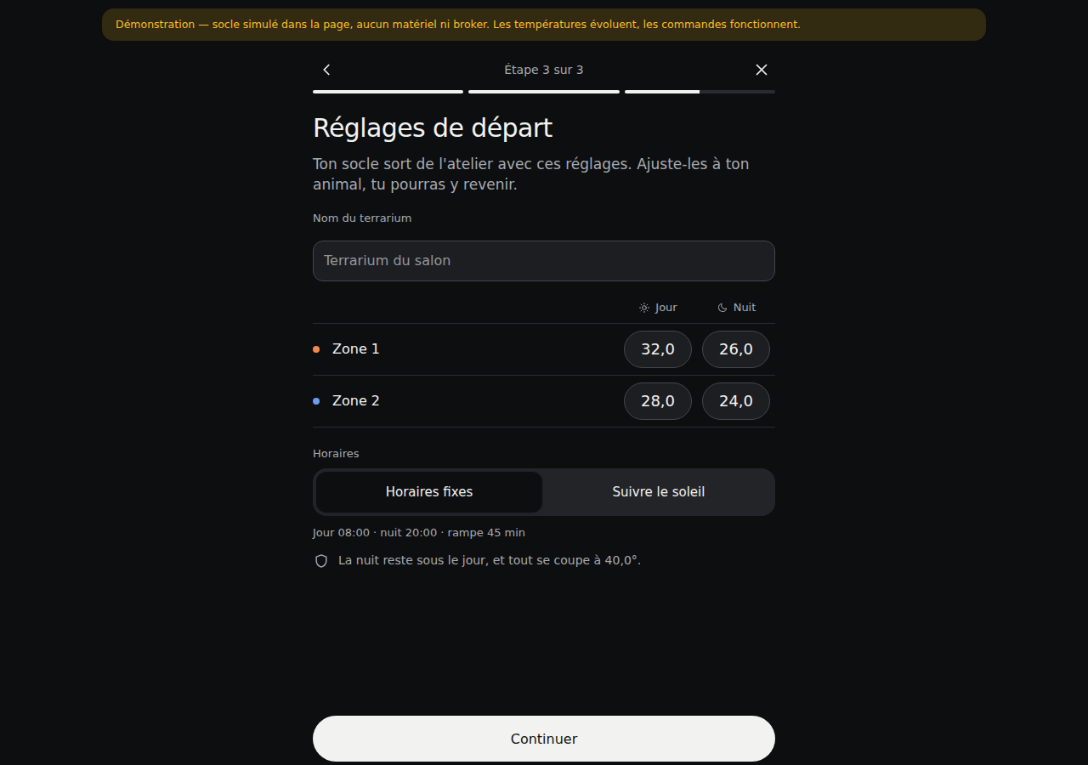
outils/references-visuelles/desktop-sombre-installation-reglages.png
