NoeMrct/terrarium_thermostat/outils/references-visuelles/desktop-sombre-installation-wifi.png

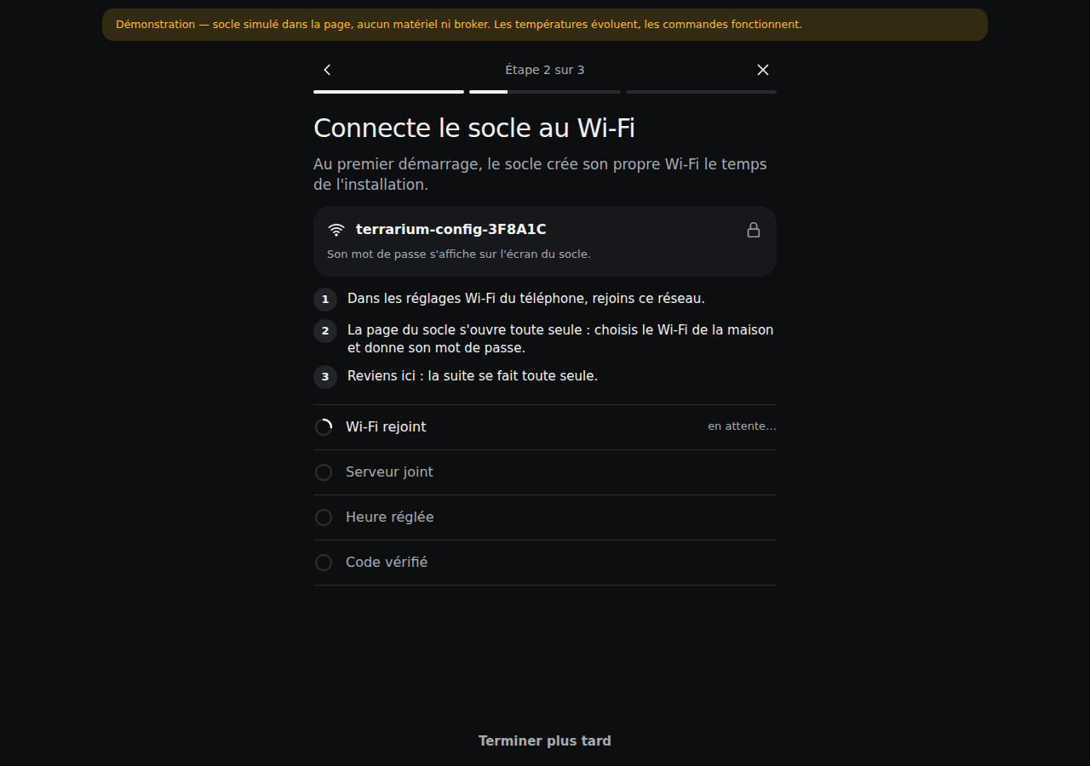
outils/references-visuelles/desktop-sombre-installation-wifi.png
