NoeMrct/terrarium_thermostat/outils/references-visuelles/desktop-sombre-installation.png

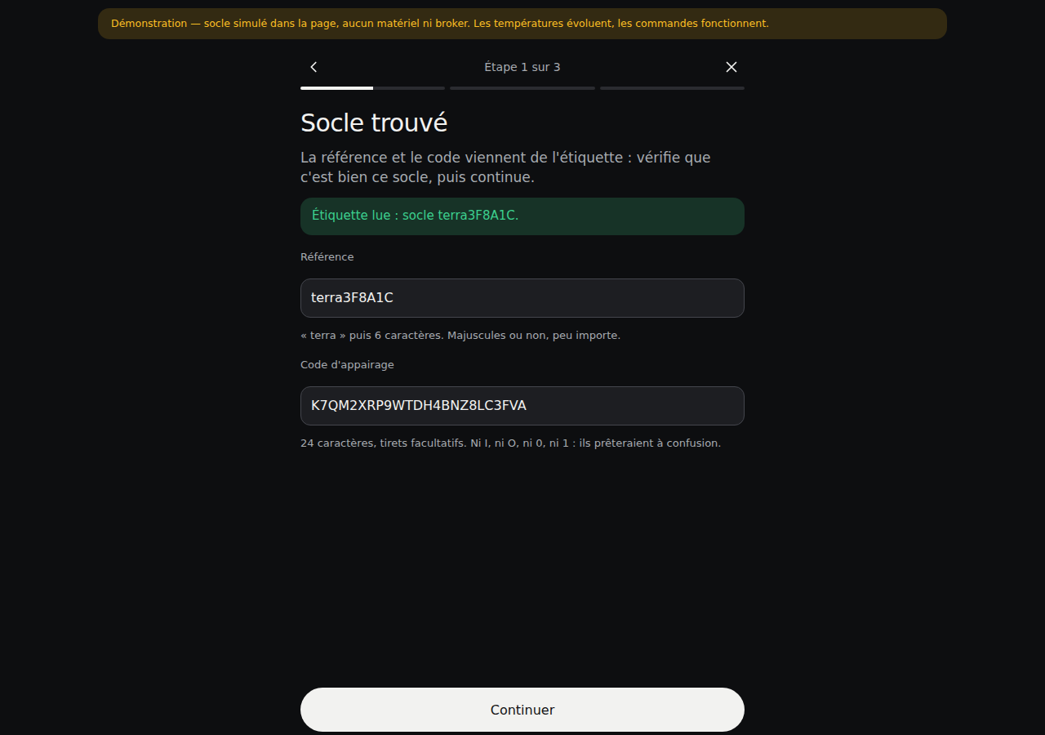
outils/references-visuelles/desktop-sombre-installation.png
