NoeMrct/terrarium_thermostat/outils/references-visuelles/mobile-clair-installation-reglages.png

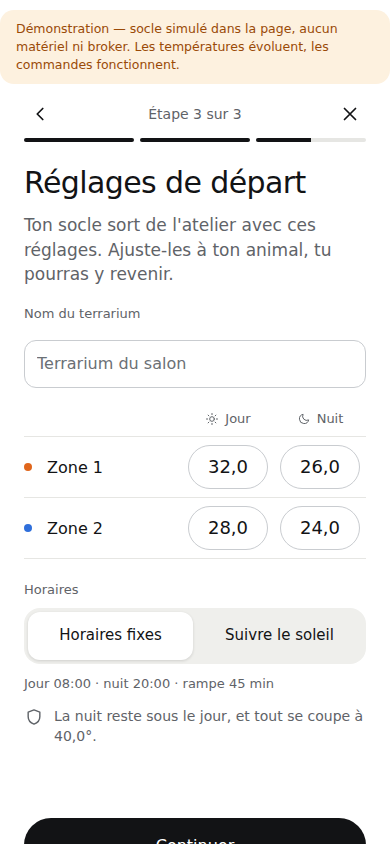
outils/references-visuelles/mobile-clair-installation-reglages.png
