NoeMrct/terrarium_thermostat/outils/references-visuelles/mobile-clair-installation-wifi.png

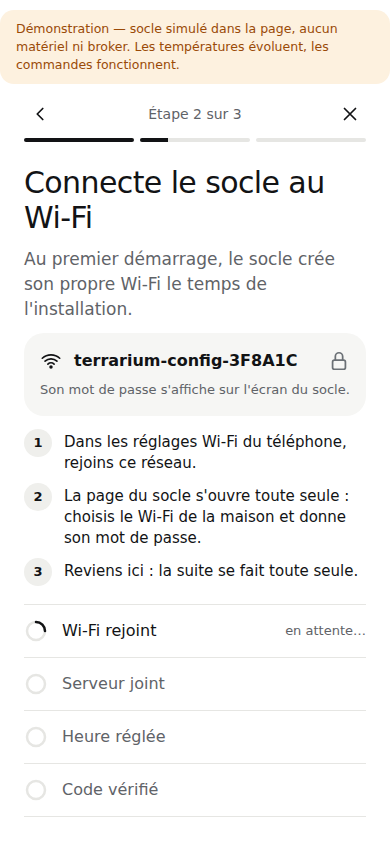
outils/references-visuelles/mobile-clair-installation-wifi.png
