NoeMrct/terrarium_thermostat/outils/references-visuelles/mobile-clair-installation.png

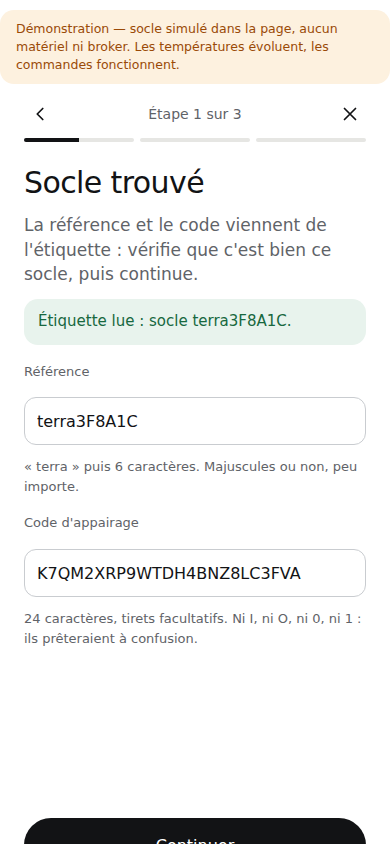
outils/references-visuelles/mobile-clair-installation.png
