NoeMrct/terrarium_thermostat/console.cpp

#include "console.h"
#include "stockage.h"
#include "sondes.h"
#include "essai.h"
#include "taches.h"
#include "reseau.h"
#include "affichage.h"
#include "courant.h"
#include "format.h"
#include <time.h>
#include <WiFi.h>
#include <esp_partition.h>

namespace {

String tampon;

// ---------------------------------------------------------------------------
// Improv Wi-Fi (série) : le protocole que parle ESP Web Tools juste après le
// flashage, pour configurer le réseau depuis la page « Flasher un socle » sans
// passer par le point d'accès. Paquet : "IMPROV" ver type longueur données
// somme (somme des octets précédents, modulo 256). Les octets qui ne forment
// pas un paquet restent des caractères de la console texte.
//   https://www.improv-wifi.com/serial/
const uint8_t IMPROV_ENTETE[6] = { 'I', 'M', 'P', 'R', 'O', 'V' };
enum : uint8_t { IMPROV_ETAT = 0x01, IMPROV_ERREUR = 0x02, IMPROV_COMMANDE = 0x03, IMPROV_RESULTAT = 0x04 };
enum : uint8_t { IMPROV_PRET = 0x02, IMPROV_EN_COURS = 0x03, IMPROV_CONFIGURE = 0x04 };
enum : uint8_t {
  IMPROV_CMD_WIFI = 0x01,
  IMPROV_CMD_ETAT = 0x02,
  IMPROV_CMD_INFO = 0x03,
  IMPROV_CMD_SCAN = 0x04
};
enum : uint8_t {
  IMPROV_ERR_AUCUNE = 0x00,
  IMPROV_ERR_PAQUET = 0x01,
  IMPROV_ERR_COMMANDE = 0x02,
  IMPROV_ERR_CONNEXION = 0x03
};

uint8_t g_imp[270];
size_t g_impN = 0;
uint32_t g_impDernier = 0;

void improvEnvoyer(uint8_t type, const uint8_t *donnees, size_t n) {
  uint8_t paquet[270];
  size_t k = 0;
  memcpy(paquet, IMPROV_ENTETE, 6);
  k = 6;
  paquet[k++] = 1;
  paquet[k++] = type;
  paquet[k++] = (uint8_t)n;
  memcpy(paquet + k, donnees, n);
  k += n;
  uint8_t somme = 0;
  for (size_t i = 0; i < k; i++) somme = (uint8_t)(somme + paquet[i]);
  paquet[k++] = somme;
  paquet[k++] = '\n';
  Serial.write(paquet, k);
  Serial.flush();
}

void improvEtat(uint8_t etat) { improvEnvoyer(IMPROV_ETAT, &etat, 1); }
void improvErreur(uint8_t code) { improvEnvoyer(IMPROV_ERREUR, &code, 1); }

// Résultat d'une commande : la commande, puis des chaînes préfixées de leur longueur.
void improvResultat(uint8_t commande, const char *const *chaines, size_t nb) {
  uint8_t d[260];
  size_t k = 2;
  for (size_t i = 0; i < nb; i++) {
    const size_t l = strlen(chaines[i]);
    if (k + 1 + l > sizeof d) break;
    d[k++] = (uint8_t)l;
    memcpy(d + k, chaines[i], l);
    k += l;
  }
  d[0] = commande;
  d[1] = (uint8_t)(k - 2);
  improvEnvoyer(IMPROV_RESULTAT, d, k);
}

void improvUrl(uint8_t commande) {
  const String url = "http://" + Reseau::adresse() + "/";
  const char *c[1] = { url.c_str() };
  improvResultat(commande, c, 1);
}

void improvCommande(const uint8_t *d, size_t n) {
  if (n < 2 || d[1] + 2u > n) {
    improvErreur(IMPROV_ERR_PAQUET);
    return;
  }
  const uint8_t cmd = d[0];
  const uint8_t *arg = d + 2;
  const size_t na = d[1];
  if (cmd == IMPROV_CMD_ETAT) {
    const bool configure = Reseau::connecte();
    improvEtat(configure ? IMPROV_CONFIGURE : IMPROV_PRET);
    if (configure) improvUrl(IMPROV_CMD_ETAT);
    return;
  }
  if (cmd == IMPROV_CMD_INFO) {
    const String id = Reseau::identifiant();
    const char *c[4] = { "Socle chauffant", FW_VERSION, "ESP32", id.c_str() };
    improvResultat(IMPROV_CMD_INFO, c, 4);
    return;
  }
  if (cmd == IMPROV_CMD_SCAN) {
    if (Reseau::modePointAcces()) WiFi.mode(WIFI_AP_STA);
    const int nb = WiFi.scanNetworks();
    for (int i = 0; i < nb && i < 30; i++) {
      const String ssid = WiFi.SSID(i), rssi = String(WiFi.RSSI(i));
      const char *c[3] = { ssid.c_str(), rssi.c_str(),
                           WiFi.encryptionType(i) == WIFI_AUTH_OPEN ? "NO" : "YES" };
      improvResultat(IMPROV_CMD_SCAN, c, 3);
    }
    WiFi.scanDelete();
    if (Reseau::modePointAcces()) WiFi.mode(WIFI_AP);
    improvResultat(IMPROV_CMD_SCAN, nullptr, 0);
    return;
  }
  if (cmd == IMPROV_CMD_WIFI) {
    char ssid[33] = "", mdp[65] = "";
    if (na < 1 || arg[0] > 32 || 1u + arg[0] > na) {
      improvErreur(IMPROV_ERR_PAQUET);
      return;
    }
    memcpy(ssid, arg + 1, arg[0]);
    ssid[arg[0]] = '\0';
    const size_t pm = 1 + arg[0];
    if (pm < na) {
      const uint8_t lm = arg[pm];
      if (lm > 64 || pm + 1 + lm > na) {
        improvErreur(IMPROV_ERR_PAQUET);
        return;
      }
      memcpy(mdp, arg + pm + 1, lm);
      mdp[lm] = '\0';
    }
    improvEtat(IMPROV_EN_COURS);
    if (Reseau::essayerWifi(ssid, mdp, 25000)) {
      improvEtat(IMPROV_CONFIGURE);
      const String url = "http://" + WiFi.localIP().toString() + "/";
      const char *c[1] = { url.c_str() };
      improvResultat(IMPROV_CMD_WIFI, c, 1);
      journal("Wi-Fi configure par Improv : redemarrage en mode station");
      delay(1500);
      ESP.restart();
    } else {
      improvErreur(IMPROV_ERR_CONNEXION);
      improvEtat(IMPROV_PRET);
    }
    return;
  }
  improvErreur(IMPROV_ERR_COMMANDE);
}

// Consomme un octet s'il appartient à un paquet Improv (en cours ou possible).
// false : l'octet est du texte pour la console.
bool improvOctet(uint8_t c, String &texte) {
  const uint32_t maintenant = millis();
  if (g_impN && maintenant - g_impDernier > 1000) {  // paquet abandonné : c'était du texte
    for (size_t i = 0; i < g_impN; i++) texte += (char)g_imp[i];
    g_impN = 0;
  }
  g_impDernier = maintenant;
  if (g_impN < 6) {
    if (c != IMPROV_ENTETE[g_impN]) {
      for (size_t i = 0; i < g_impN; i++) texte += (char)g_imp[i];
      g_impN = 0;
      return false;
    }
    g_imp[g_impN++] = c;
    return true;
  }
  g_imp[g_impN++] = c;
  if (g_impN < 9) return true;              // version, type, longueur
  const size_t total = 9u + g_imp[8] + 1u;  // + données + somme
  if (g_impN < total) return true;
  uint8_t somme = 0;
  for (size_t i = 0; i + 1 < total; i++) somme = (uint8_t)(somme + g_imp[i]);
  const uint8_t type = g_imp[7];
  if (somme != g_imp[total - 1] || g_imp[6] != 1)
    improvErreur(IMPROV_ERR_PAQUET);
  else if (type == IMPROV_COMMANDE)
    improvCommande(g_imp + 9, g_imp[8]);
  else
    improvErreur(IMPROV_ERR_COMMANDE);
  g_impN = 0;
  return true;
}

String hhmm(uint16_t m) {
  char b[8];
  formatHHMM(m, b, sizeof b);
  return String(b);
}

bool parseHHMM(const String &s, uint16_t &out) { return formatParseHHMM(s.c_str(), out); }

uint8_t decouper(const String &cmd, String jetons[6]) {
  uint8_t n = 0;
  int depart = 0;
  while (n < 6) {
    const int e = cmd.indexOf(' ', depart);
    if (e < 0) {
      jetons[n++] = cmd.substring(depart);
      break;
    }
    if (e > depart) jetons[n++] = cmd.substring(depart, e);
    depart = e + 1;
  }
  return n;
}

// Les réglages globaux passent tous par ici : mêmes bornes que l'interface web
// et que le canal MQTT, puisque la validation vit dans stockage.cpp.
bool appliquerGlobaux(const ReglagesGlobaux &n) {
  char erreur[100];
  if (!Stockage::globauxValides(n, erreur, sizeof erreur)) {
    Serial.printf("Refuse : %s\n", erreur);
    return false;
  }
  Stockage::globaux() = n;
  Stockage::sauverGlobaux();
  appliquerReglagesGlobaux();
  return true;
}

void appliquer(uint8_t z, const ReglagesZone &n) {
  char erreur[100];
  if (!reglagesValides(n, erreur, sizeof erreur)) {
    Serial.printf("Refuse : %s\n", erreur);
    return;
  }
  ctrl.cfg[z] = n;
  Stockage::sauverZone(z, n);
  const ReglagesZone &c = ctrl.cfg[z];
  Serial.printf("%s : jour %.1f  nuit %.1f  %s->%s  bande %.2f  ki %.5f  max %.1f  offset %+.2f\n", c.nom,
                c.consigneJour, c.consigneNuit, hhmm(c.debutJour).c_str(), hhmm(c.debutNuit).c_str(), c.bande,
                c.ki, c.tempMax, c.offset);
}

void traiter(String cmd) {
  cmd.trim();
  if (!cmd.length()) return;

  String j[6];
  const uint8_t n = decouper(cmd, j);
  const String &v = j[0];

  Affichage::reveiller();  // toute commande rallume l'écran

  if (v == "help") {
    Console::aide();
    return;
  }
  if (v == "jeton") {
    if (n >= 2 && j[1] == "nouveau") {
      Stockage::regenererJeton();
      Serial.println(F("Nouveau code genere : les applications deja appairees devront etre reappairees."));
    }
    Serial.printf("Appareil %s\nCode d'appairage : %s\n", Reseau::identifiant().c_str(),
                  Stockage::reseau().jeton);
    Affichage::appairage(Reseau::identifiant().c_str(), Stockage::reseau().jeton, 30);
    return;
  }
  if (v == "version") {
    Serial.printf("Firmware %s, compile le %s, protocole %d\n", FW_VERSION, FW_BUILD, PROTO_VERSION);
    return;
  }
  if (v == "sante") {
    Serial.printf("Sante : {%s}\n", Reseau::sante().c_str());
    if (resumePlantage()[0]) Serial.printf("Dernier plantage : %s\n", resumePlantage());
    return;
  }
  if (v == "coredump") {
    if (n >= 2 && j[1] == "effacer") {
      Serial.println(Reseau::effacerCoredump() ? F("Coredump efface.") : F("Aucun coredump a effacer."));
    } else {
      Serial.println(resumePlantage()[0] ? resumePlantage() : "Aucun coredump en flash.");
      Serial.println(F("Fichier complet : GET /api/coredump ; `coredump effacer` pour le supprimer."));
    }
    return;
  }
  if (v == "appairage") {
    Affichage::appairage(Reseau::identifiant().c_str(), Stockage::reseau().jeton, 60);
    Serial.println(F("QR d'appairage affiche pendant 60 s."));
    return;
  }
  if (v == "maj") {
    if (n < 2) {
      const EtatMaj &m = Stockage::etatMaj();
      Serial.printf("Derniere mise a jour : %s %s (%s)\nUsage : maj <version X.Y.Z | url https://...>\n",
                    nomEtapeMaj(m.etape), m.version, m.detail);
      return;
    }
    char erreur[96];
    Reseau::mettreAJour(j[1], erreur, sizeof erreur);  // ne revient qu'en cas de refus
    Serial.printf("Mise a jour refusee : %s\n", erreur);
    return;
  }
  if (v == "test" && n >= 2 && j[1] == "usine") {
    Console::testUsine(n >= 3 && j[2] == "oui");
    return;
  }
  if (v == "stats") {
    const ReglagesGlobaux &g = Stockage::globaux();
    Serial.printf("Alimentation %.1f A -> %u zone(s) simultanee(s)  |  saison %+.2f C\n", g.courantAlimA,
                  ctrl.limiteZones(), ctrl.decalageSaison());
    for (uint8_t z = 0; z < NB_ZONES; z++) {
      const uint32_t sec = secondesChauffeTotales(z);
      Serial.printf("  %-12s %6.1f h de chauffe  %6.3f kWh", ctrl.cfg[z].nom, sec / 3600.0f,
                    Taches::kwh(sec));
      if (g.prixKwh > 0.0f) Serial.printf(" = %.2f EUR", Taches::euros(sec));
      Serial.printf("  defauts sonde/surchauffe/figee/sans effet : %u/%u/%u/%u\n",
                    ctrl.zone[z].nbDefauts[DEF_SONDE], ctrl.zone[z].nbDefauts[DEF_SURCHAUFFE],
                    ctrl.zone[z].nbDefauts[DEF_FIGE], ctrl.zone[z].nbDefauts[DEF_INEFFICACE]);
    }
    return;
  }
  if (v == "status") {
    Console::etat();
    return;
  }
  if (v == "scan") {
    Sondes::rescanner();  // une sonde branchée depuis le démarrage devient visible
    Serial.print(Sondes::inventaireTexte());
    return;
  }
  if (v == "identifier") {
    char message[140];
    if (n >= 2 && j[1] == "stop") {
      Sondes::annulerIdentification();
      Serial.println(F("Identification annulee."));
      return;
    }
    const int z = (n >= 2) ? j[1].toInt() : 0;
    if (z < 1 || z > (int)NB_ZONES) {
      Serial.println(F("Usage : identifier <zone> | identifier stop"));
      return;
    }
    Sondes::lancerIdentification((uint8_t)(z - 1), message, sizeof message);
    Serial.println(message);
    return;
  }
  if (v == "journal") {
    Serial.println(Stockage::journalQueue(4000));
    return;
  }
  if (v == "reseau") {
    const ReglagesReseau &r = Stockage::reseau();
    Serial.printf("Appareil %s  (racine des sujets MQTT : %s/%s)\n", Reseau::identifiant().c_str(),
                  r.mqttPrefixe, Reseau::identifiant().c_str());
    if (r.ssid2[0]) Serial.printf("Reseau de secours '%s'\n", r.ssid2);
    Serial.printf("SSID '%s'  etat %s  adresse %s\n", r.ssid,
                  Reseau::modePointAcces() ? "point d'acces de config"
                                           : (Reseau::connecte() ? "connecte" : "hors ligne"),
                  Reseau::adresse().c_str());
    Serial.printf("Web %s  OTA reseau %s\n", r.webUtilisateur[0] ? "protege" : "libre",
                  Reseau::otaActive() ? "active et protegee"
                                      : "DESACTIVEE (aucun mot de passe : `motdepasse ota <mdp>`)");
    if (r.mqttActif)
      Serial.printf("MQTT %s:%u%s  utilisateur '%s'  %s\n", r.mqttHote, (unsigned)r.mqttPort,
                    r.mqttTls ? " (TLS)" : "", r.mqttUtilisateur, Reseau::etatMqtt().c_str());
    else
      Serial.println(F("MQTT desactive"));
    Serial.printf("Alertes %s%s  heartbeat %s (%u min)\n", r.urlAlertes[0] ? r.urlAlertes : "desactivees",
                  r.alerteJeton[0] ? " [jeton]" : "", r.urlHeartbeat[0] ? r.urlHeartbeat : "desactive",
                  r.heartbeatMinutes);
    Serial.printf("Fuseau %s  NTP %s  heure %s  alertes en attente %u\n", r.fuseau, r.ntp,
                  heureFiable() ? (horodatage() + (heureApproximative() ? " (approximative)" : "")).c_str()
                                : "inconnue",
                  Stockage::alertesEnAttente());
    return;
  }
  if (v == "reset") {
    ctrl.leverDefauts(millis());
    uint8_t d[NB_ZONES] = { DEF_AUCUN, DEF_AUCUN };
    Stockage::sauverDefauts(d);
    Serial.println(F("Defauts leves. Verifie sondes, tapis et cablage."));
    return;
  }
  if (v == "off") {
    // Verrouillage volontaire : on reutilise le mecanisme de defaut (c'est lui
    // qui survit a un redemarrage), mais sans compter une panne qui n'a pas eu
    // lieu dans les statistiques.
    for (uint8_t z = 0; z < NB_ZONES; z++) ctrl.declencherDefaut(z, DEF_SURCHAUFFE, millis(), false);
    Serial.println(F("Tout coupe et verrouille. `reset` pour repartir."));
    return;
  }
  if (v == "entretien") {
    const uint16_t min = (n >= 2) ? (uint16_t)j[1].toInt() : Stockage::globaux().maintenanceMin;
    if (min > 240) {
      Serial.println(F("Duree limitee a 240 min."));
      return;
    }
    ctrl.maintenance(millis(), min);
    return;
  }
  if (v == "alim" && n >= 2) {
    ReglagesGlobaux g = Stockage::globaux();
    g.courantAlimA = j[1].toFloat();
    if (n >= 3) g.puissanceTapisW = j[2].toFloat();
    if (n >= 4) g.tensionV = j[3].toFloat();
    if (!appliquerGlobaux(g)) return;
    Serial.printf("Alimentation %.1f A sous %.1f V, tapis %.0f W -> %u zone(s) simultanee(s)\n",
                  g.courantAlimA, g.tensionV, g.puissanceTapisW, ctrl.limiteZones());
    return;
  }
  if (v == "entretien-defaut" && n >= 2) {
    ReglagesGlobaux g = Stockage::globaux();
    g.maintenanceMin = (uint16_t)j[1].toInt();
    if (!appliquerGlobaux(g)) return;
    Serial.printf("Duree d'entretien par defaut : %u min\n", g.maintenanceMin);
    return;
  }
  if (v == "saison") {
    ReglagesGlobaux g = Stockage::globaux();
    if (n >= 2 && j[1] == "off") {
      g.saisonActive = false;
      if (!appliquerGlobaux(g)) return;
      Serial.println(F("Cyclage saisonnier desactive."));
      return;
    }
    if (n >= 3) {
      g.saisonDelta = j[1].toFloat();
      g.saisonDescenteJ = (uint16_t)j[2].toInt();
      if (n >= 4) g.saisonPlateauJ = (uint16_t)j[3].toInt();
      if (n >= 5) g.saisonRemonteeJ = (uint16_t)j[4].toInt();
      if (!heureFiable()) {
        Serial.println(F("Heure inconnue : impossible de dater le cycle."));
        return;
      }
      g.saisonDebutEpoch = (uint32_t)time(nullptr);
      g.saisonActive = true;
      if (!appliquerGlobaux(g)) return;
    }
    const ReglagesGlobaux &c = Stockage::globaux();
    Serial.printf(
        "Saison %s : -%.1f C, %u j de descente, %u j de plateau, %u j de remontee (decalage actuel %+.2f "
        "C)\n",
        c.saisonActive ? "active" : "inactive", c.saisonDelta, c.saisonDescenteJ, c.saisonPlateauJ,
        c.saisonRemonteeJ, ctrl.decalageSaison());
    return;
  }
  if (v == "ecran" && n >= 3 && j[1] == "nuit") {
    ReglagesGlobaux g = Stockage::globaux();
    if (j[2] == "attenue")
      g.ecranNuit = ECRAN_NUIT_ATTENUE;
    else if (j[2] == "normal")
      g.ecranNuit = ECRAN_NUIT_NORMAL;
    else if (j[2] == "eteint")
      g.ecranNuit = ECRAN_NUIT_ETEINT;
    else {
      Serial.println(F("Usage : ecran nuit <attenue|normal|eteint>"));
      return;
    }
    if (!appliquerGlobaux(g)) return;
    Serial.printf("La nuit, l'ecran est %s.\n", j[2].c_str());
    return;
  }
  if (v == "led" && n >= 2) {
    ReglagesGlobaux g = Stockage::globaux();
    g.ledEteinte = (j[1] == "off");
    if (!appliquerGlobaux(g)) return;
    Serial.println(g.ledEteinte ? F("LED d'etat eteinte.") : F("LED d'etat allumee."));
    return;
  }
  if (v == "prix" && n >= 2) {
    ReglagesGlobaux g = Stockage::globaux();
    g.prixKwh = j[1] == "off" ? 0.0f : j[1].toFloat();
    if (!appliquerGlobaux(g)) return;
    if (g.prixKwh > 0.0f)
      Serial.printf("Prix du kWh : %.4f EUR (cout affiche dans `stats`, la page et le rapport).\n",
                    g.prixKwh);
    else
      Serial.println(F("Prix du kWh inconnu : aucun cout affiche."));
    return;
  }
  if (v == "rapport") {
    ReglagesGlobaux g = Stockage::globaux();
    if (n < 2) {
      Serial.println(Taches::rapport());
      return;
    }
    if (j[1] == "envoyer") {
      Taches::envoyerRapport();
      Serial.println(F("Rapport envoye vers les alertes."));
      return;
    }
    if (j[1] == "off") {
      g.rapportActif = false;
    } else {
      uint16_t m = 0;
      if (!parseHHMM(j[1], m)) {
        Serial.println(F("Usage : rapport | rapport <HH:MM> | rapport off | rapport envoyer"));
        return;
      }
      g.rapportActif = true;
      g.rapportMinutes = m;
    }
    if (!appliquerGlobaux(g)) return;
    if (g.rapportActif)
      Serial.printf("Rapport quotidien a %s, vers l'URL d'alertes et le sujet MQTT « rapport ».\n",
                    j[1].c_str());
    else
      Serial.println(F("Rapport quotidien desactive."));
    return;
  }
  if (v == "jours") {
    Serial.print(Taches::joursTexte(n >= 2 ? (uint16_t)j[1].toInt() : 14));
    return;
  }
  if (v == "soleil" && n >= 2) {
    ReglagesGlobaux g = Stockage::globaux();
    if (j[1] == "off") {
      g.soleilActif = false;
    } else if (n >= 3) {
      g.latitude = j[1].toFloat();
      g.longitude = j[2].toFloat();
      g.soleilDecalageMin = (int16_t)(n >= 4 ? j[3].toInt() : 0);
      g.soleilActif = true;
    } else {
      Serial.println(F("Usage : soleil <latitude> <longitude> [decalage min] | soleil off"));
      return;
    }
    if (!appliquerGlobaux(g)) return;
    if (ctrl.soleilActif())
      Serial.printf("Jour a %s, nuit a %s aujourd'hui (suit le soleil).\n", hhmm(ctrl.debutJour(0)).c_str(),
                    hhmm(ctrl.debutNuit(0)).c_str());
    else
      Serial.println(g.soleilActif ? F("Enregistre : applique des que l'heure sera connue.")
                                   : F("Horaires fixes de chaque zone."));
    return;
  }
  if (v == "priorite" && n >= 2) {
    ReglagesGlobaux g = Stockage::globaux();
    g.zonePrioritaire = j[1] == "off" ? 0 : (uint8_t)j[1].toInt();
    if (!appliquerGlobaux(g)) return;
    if (g.zonePrioritaire)
      Serial.printf("Zone %u prioritaire quand l'alimentation ne suffit pas a tout le monde.\n",
                    g.zonePrioritaire);
    else
      Serial.println(F("Aucune zone prioritaire."));
    return;
  }
  if (v == "essai" && n >= 2) {
    char message[200];
    if (j[1] == "stop") {
      Essai::annuler();
      Serial.println(F("Essai arrete."));
      return;
    }
    const int z = j[1].toInt();
    if (z < 1 || z > (int)NB_ZONES) {
      Serial.println(F("Usage : essai <zone> | essai stop"));
      return;
    }
    Essai::lancer((uint8_t)(z - 1), message, sizeof message);
    Serial.println(message);
    return;
  }
  if (v == "calibrer") {
    char message[200];
    Essai::calibrer(message, sizeof message);
    Serial.println(message);
    return;
  }
  if (v == "wifi2" && n >= 2) {
    ReglagesReseau &r = Stockage::reseau();
    if (j[1] == "off") {
      r.ssid2[0] = '\0';
      r.motDePasse2[0] = '\0';
    } else {
      snprintf(r.ssid2, sizeof r.ssid2, "%s", j[1].c_str());
      snprintf(r.motDePasse2, sizeof r.motDePasse2, "%s", n >= 3 ? j[2].c_str() : "");
    }
    Stockage::sauverReseau();
    Serial.println(r.ssid2[0]
                       ? F("Reseau de secours enregistre : essaye en alternance si le premier ne repond pas.")
                       : F("Reseau de secours retire."));
    return;
  }
  if (v == "ecran" && n >= 2) {
    ReglagesGlobaux g = Stockage::globaux();
    g.ecranVeilleMin = (uint16_t)j[1].toInt();
    if (!appliquerGlobaux(g)) return;
    Serial.printf("Veille de l'ecran : %u min%s\n", g.ecranVeilleMin,
                  g.ecranVeilleMin == 0 ? " (jamais)" : "");
    return;
  }
  if (v == "redemarrer") {
    Serial.println(F("Redemarrage..."));
    delay(200);
    ESP.restart();
    return;
  }
  if (v == "effacer-historique") {
    Stockage::histEffacer();
    Serial.println(F("Historique efface."));
    return;
  }

  if (v == "wifi" && n == 2 && j[1] == "off") {
    // Fin de ligne à l'atelier : le socle oublie le Wi-Fi du banc et ouvre son
    // point d'accès de configuration dès le démarrage chez l'acheteur, au lieu
    // de chercher trois minutes un réseau qu'il ne trouvera jamais.
    ReglagesReseau &r = Stockage::reseau();
    r.ssid[0] = '\0';
    r.motDePasse[0] = '\0';
    Stockage::sauverReseau();
    Serial.println(F("WiFi oublie : point d'acces de configuration au prochain demarrage."));
    return;
  }
  if (v == "wifi" && n >= 2) {
    // Essai immédiat : on sait tout de suite si les identifiants sont bons, et
    // ils ne sont enregistrés que dans ce cas.
    Serial.printf("Connexion a '%s'...\n", j[1].c_str());
    if (Reseau::essayerWifi(j[1].c_str(), n >= 3 ? j[2].c_str() : "", 20000)) {
      Serial.printf("Connecte, adresse %s. WiFi enregistre : `redemarrer` pour passer en mode station.\n",
                    WiFi.localIP().toString().c_str());
    } else {
      Serial.println(F("Echec de connexion : SSID ou mot de passe refuse, rien n'est enregistre."));
    }
    return;
  }
  if (v == "motdepasse" && n >= 3) {
    ReglagesReseau &r = Stockage::reseau();
    if (j[1] == "web") {
      if (n >= 4)
        snprintf(r.webUtilisateur, sizeof r.webUtilisateur, "%s", j[3].c_str());
      else if (!r.webUtilisateur[0])
        snprintf(r.webUtilisateur, sizeof r.webUtilisateur, "admin");
      snprintf(r.webHachage, sizeof r.webHachage, "%s",
               Reseau::empreinte(String(r.webUtilisateur) + ":" + j[2]).c_str());
    } else if (j[1] == "ota")
      snprintf(r.otaMotDePasse, sizeof r.otaMotDePasse, "%s", j[2].c_str());
    else if (j[1] == "ap") {
      if (j[2].length() < 8) {
        Serial.println(F("8 caracteres minimum pour le point d'acces."));
        return;
      }
      snprintf(r.apMotDePasse, sizeof r.apMotDePasse, "%s", j[2].c_str());
    } else {
      Serial.println(F("Usage : motdepasse <web|ota|ap> <mot de passe> [utilisateur]"));
      return;
    }
    Stockage::sauverReseau();
    Serial.println(F("Enregistre. `redemarrer` pour appliquer."));
    return;
  }
  if (v == "url" && n >= 3) {
    ReglagesReseau &r = Stockage::reseau();
    if (j[1] == "alertes")
      snprintf(r.urlAlertes, sizeof r.urlAlertes, "%s", j[2].c_str());
    else if (j[1] == "heartbeat")
      snprintf(r.urlHeartbeat, sizeof r.urlHeartbeat, "%s", j[2].c_str());
    else if (j[1] == "jeton")
      snprintf(r.alerteJeton, sizeof r.alerteJeton, "%s", j[2] == "off" ? "" : j[2].c_str());
    else {
      Serial.println(F("Usage : url <alertes|heartbeat|jeton> <valeur>"));
      return;
    }
    Stockage::sauverReseau();
    Serial.println(F("Enregistre."));
    return;
  }
  if (v == "mqtt" && n >= 3 && j[1] == "tls") {
    Stockage::reseau().mqttTls = (j[2] == "on" || j[2] == "1");
    if (Stockage::reseau().mqttTls && Stockage::reseau().mqttPort == 1883) Stockage::reseau().mqttPort = 8883;
    Stockage::sauverReseau();
    Serial.printf("MQTT chiffre : %s (port %u). `redemarrer` pour appliquer.\n",
                  Stockage::reseau().mqttTls ? "oui" : "non", Stockage::reseau().mqttPort);
    return;
  }
  if (v == "mqtt" && n >= 2) {
    ReglagesReseau &r = Stockage::reseau();
    snprintf(r.mqttHote, sizeof r.mqttHote, "%s", j[1] == "off" ? "" : j[1].c_str());
    if (j[1] == "off") {
      // Les identifiants d'un broker abandonné n'ont plus à rester en mémoire
      // (un socle rodé sur le broker de l'atelier part sans eux).
      r.mqttUtilisateur[0] = '\0';
      r.mqttMotDePasse[0] = '\0';
      r.mqttPort = 1883;
      r.mqttTls = false;
    }
    if (n >= 3) r.mqttPort = (uint16_t)j[2].toInt();
    if (n >= 6) r.mqttTls = (j[5] == "tls" || j[5] == "1");
    if (n >= 5) {
      snprintf(r.mqttUtilisateur, sizeof r.mqttUtilisateur, "%s", j[3].c_str());
      snprintf(r.mqttMotDePasse, sizeof r.mqttMotDePasse, "%s", j[4].c_str());
    }
    if (r.mqttPort == 0) r.mqttPort = 1883;
    r.mqttActif = r.mqttHote[0] != '\0';
    Stockage::sauverReseau();
    Serial.println(F("MQTT enregistre. `redemarrer` pour appliquer."));
    return;
  }
  if (v == "lier" && n >= 3) {
    const int idx = j[1].toInt(), z = j[2].toInt();
    if (z < 1 || z > (int)NB_ZONES) {
      Serial.println(F("Zone invalide."));
      return;
    }
    char message[140];
    Sondes::lierParIndex((uint8_t)idx, (uint8_t)(z - 1), message, sizeof message);
    Serial.println(message);
    return;
  }

  // --- commandes de zone ---
  if (n < 2) {
    Serial.println(F("Commande inconnue. `help`."));
    return;
  }
  const int numZ = j[1].toInt();
  if (numZ < 1 || numZ > (int)NB_ZONES) {
    Serial.println(F("Zone invalide."));
    return;
  }
  const uint8_t z = (uint8_t)(numZ - 1);
  ReglagesZone c = ctrl.cfg[z];

  if (v == "autotune") {
    char err[80] = "";
    if (ctrl.lancerAutotune(z, millis(), err, sizeof err))
      Serial.println(F("Autotune lance : la zone va osciller volontairement pendant ~1 h."));
    else
      Serial.printf("Refuse : %s\n", err);
    return;
  }
  if (v == "stop-autotune") {
    ctrl.arreterAutotune(z);
    Serial.println(F("Autotune arrete."));
    return;
  }

  if (n < 3) {
    Serial.println(F("Il manque une valeur. `help`."));
    return;
  }
  const float val = j[2].toFloat();

  if (v == "nom") {
    // Tout ce qui suit le numero de zone, espaces internes compris. Chercher
    // simplement la premiere occurrence du 3e jeton dans la ligne donnait
    // « 1 1 » pour `nom 1 1`, ou « nom 2 nom » pour `nom 2 nom`.
    int p = cmd.indexOf(' ');                           // fin du mot-cle
    while (p >= 0 && cmd[(unsigned)p] == ' ') p++;      // debut du numero de zone
    p = (p >= 0) ? cmd.indexOf(' ', (unsigned)p) : -1;  // fin du numero de zone
    while (p >= 0 && cmd[(unsigned)p] == ' ') p++;      // debut du texte
    snprintf(c.nom, sizeof c.nom, "%s", (p > 0) ? cmd.substring(p).c_str() : j[2].c_str());
  } else if (v == "jour")
    c.consigneJour = val;
  else if (v == "nuit")
    c.consigneNuit = val;
  else if (v == "bande")
    c.bande = val;
  else if (v == "ki")
    c.ki = val;
  else if (v == "max")
    c.tempMax = val;
  else if (v == "offset")
    c.offset = val;
  else if (v == "rampe")
    c.rampeMinutes = (uint16_t)j[2].toInt();
  else if (v == "derive") {
    c.deriveSeuil = val;
    if (n >= 4) c.deriveMinutes = (uint16_t)j[3].toInt();
  } else if (v == "sanseffet") {
    c.inefficaceMinutes = (uint16_t)j[2].toInt();
    if (n >= 4) c.inefficaceDelta = j[3].toFloat();
  } else if (v == "chute") {
    c.chuteSeuil = val;
    if (n >= 4) c.chuteSecondes = (uint16_t)j[3].toInt();
  } else if (v == "heures") {
    if (n < 4) {
      Serial.println(F("Usage : heures <zone> <HH:MM jour> <HH:MM nuit>"));
      return;
    }
    if (!parseHHMM(j[2], c.debutJour) || !parseHHMM(j[3], c.debutNuit)) {
      Serial.println(F("Format d'heure invalide (HH:MM)."));
      return;
    }
  } else {
    Serial.println(F("Commande inconnue. `help`."));
    return;
  }

  appliquer(z, c);
}

}  // namespace

namespace Console {

void aide() {
  Serial.println(
      F("\nCommandes (z = numero de zone) :\n"
        "  status | stats | version | sante | scan | journal | reseau | jours [n] | help\n"
        "  appairage                  QR et code d'appairage sur l'ecran (60 s)\n"
        "  maj [version|url]          mise a jour tiree depuis GitHub (ou etat de la derniere)\n"
        "  test usine [oui]           auto-test ecran, sondes, memoire, WiFi ; `oui` = MOSFET aussi\n"
        "  coredump [effacer]         resume du dernier plantage, ou effacement\n"
        "  entretien [min]            coupure temporaire, reprise automatique\n"
        "  entretien-defaut <min>     duree proposee par defaut\n"
        "  alim <amperes> [watts] [volts]  puissance disponible -> zones simultanees\n"
        "  saison <degC> <jDescente> [jPlateau] [jRemontee] | saison off\n"
        "  ecran <minutes>            veille de l'afficheur (0 = jamais)\n"
        "  ecran nuit <attenue|normal|eteint>  l'afficheur la nuit\n"
        "  led <on|off>               LED d'etat de la carte\n"
        "  rapport [HH:MM|off|envoyer] rapport quotidien (sans argument : l'afficher)\n"
        "  prix <EUR par kWh|off>     cout de la chauffe\n"
        "  soleil <lat> <lon> [min] | soleil off   jour et nuit cales sur le soleil\n"
        "  priorite <z|off>           zone servie en priorite si l'alimentation manque\n"
        "  nom <z> <texte>            renommer la zone\n"
        "  jour <z> <degC>            consigne de jour\n"
        "  nuit <z> <degC>            consigne de nuit\n"
        "  heures <z> <HH:MM> <HH:MM> debut de jour, debut de nuit\n"
        "  rampe <z> <min>            duree de transition jour/nuit\n"
        "  bande <z> <degC>           bande proportionnelle\n"
        "  ki <z> <valeur>            gain integral (par seconde et par degC)\n"
        "  max <z> <degC>             seuil de coupure absolue\n"
        "  offset <z> <degC>          calibration de la sonde\n"
        "  derive <z> <degC> [min]    seuil et delai d'alerte de derive\n"
        "  sanseffet <z> <min> [degC] detection de chauffe sans effet\n"
        "  chute <z> <degC> [s]       chute brutale : seuil et fenetre d'observation\n"
        "  autotune <z> | stop-autotune <z>\n"
        "  lier <index> <z>           associer une sonde du bus a une zone\n"
        "  identifier <z> | stop      lier la sonde que l'on chauffe dans la main\n"
        "  essai <z> | stop           essai de chauffe de mise en service (verdict)\n"
        "  calibrer                   sondes cote a cote : aligner sur la zone 1\n"
        "  wifi <ssid> [mdp] | off    essaie le reseau et l'enregistre s'il repond ; off = l'oublier\n"
        "  wifi2 <ssid> [mdp] | off   reseau de secours, essaye en alternance\n"
        "  motdepasse web <mdp> [user] | motdepasse ota <mdp> | motdepasse ap <mdp>\n"
        "  url alertes <url> | url heartbeat <url>\n"
        "  url jeton <secret|off>     jeton envoye avec les alertes (Bearer)\n"
        "  mqtt <hote|off> [port] [user] [mdp] [tls] | mqtt tls <on|off>\n"
        "  jeton [nouveau]            code d'appairage de cet appareil\n"
        "  reset                      lever les defauts verrouilles\n"
        "  off                        tout couper et verrouiller\n"
        "  effacer-historique | redemarrer\n"));
}

void etat() {
  Serial.printf("\n%s  tapis actif %d  %s  heap %u o\n", horodatage().c_str(), ctrl.tapisActif(),
                Reseau::modePointAcces() ? "AP config" : Reseau::adresse().c_str(),
                (unsigned)ESP.getFreeHeap());
  if (Reseau::modePointAcces())
    Serial.printf("  point d'acces %s  mot de passe %s\n", Reseau::ssidConfiguration().c_str(),
                  Stockage::reseau().apMotDePasse);
  for (uint8_t z = 0; z < NB_ZONES; z++) {
    const ZoneEtat &s = ctrl.zone[z];
    Serial.printf("  %-12s %6.2f C -> %5.2f C  demande %3d%%  charge %3.0f%%  I=%+.2f  biais %.2f  %s%s\n",
                  ctrl.cfg[z].nom, s.temperature, s.consigneEff, (int)lroundf(s.demande * 100), ctrl.duty(z),
                  s.integrale, s.biais, nomDefaut(s.defaut),
                  (s.autotune == AT_ATTENTE || s.autotune == AT_OSCILLE)
                      ? "  [autotune]"
                      : (s.deriveActive ? "  [derive]" : ""));
  }
}

void boucle() {
  while (Serial.available()) {
    const uint8_t c = (uint8_t)Serial.read();
    if (improvOctet(c, tampon)) continue;
    if (c == '\n' || c == '\r') {
      const String l = tampon;
      tampon = "";
      traiter(l);
    } else if (tampon.length() < 120)
      tampon += (char)c;
  }
}

// ---------------------------------------------------------------------------
// Test usine : un verdict par organe, en fin de ligne de production ou au
// retour d'un socle en SAV. Sans « oui », les MOSFET ne sont pas actionnés
// (rien ne doit chauffer sur un établi sans tapis ni mesure).
void testUsine(bool puissance) {
  uint8_t echecs = 0;
  auto verdict = [&](bool ok, const char *organe, const String &detail) {
    if (!ok) echecs++;
    Serial.printf("  [%s] %-14s %s\n", ok ? " OK " : "ECHEC", organe, detail.c_str());
  };
  Serial.printf("\n=== TEST USINE  %s  firmware %s ===\n", Reseau::identifiant().c_str(), FW_VERSION);

  verdict(Affichage::mire(1500), "ecran",
          Affichage::present() ? "mire affichee 1,5 s (plein puis damier)" : "OLED absent");

  const uint8_t sondes = Sondes::nombreDetecte();
  verdict(sondes >= NB_ZONES, "sondes",
          String(sondes) + " detectee(s) sur " + String(NB_ZONES) + " attendue(s)");

  verdict(Stockage::testNvs(), "memoire NVS", "ecriture et relecture");
  verdict(Stockage::systemeFichiersPret(), "fichiers",
          Stockage::systemeFichiersPret() ? String(Stockage::espaceLibreFichiers() / 1024) + " Ko libres"
                                          : "LittleFS non monte");

  const esp_partition_t *app1 = esp_partition_find_first(ESP_PARTITION_TYPE_APP,
                                                         ESP_PARTITION_SUBTYPE_APP_OTA_1, NULL);
  const esp_partition_t *cd = esp_partition_find_first(ESP_PARTITION_TYPE_DATA,
                                                       ESP_PARTITION_SUBTYPE_DATA_COREDUMP, NULL);
  verdict(
      app1 != nullptr, "partitions",
      app1 ? "deux emplacements OTA de " + String((unsigned)(app1->size / 1024)) + " Ko" : "ota_1 absente");
  verdict(cd != nullptr, "coredump", cd ? "partition presente" : "partition absente");

  if (Reseau::modePointAcces()) WiFi.mode(WIFI_AP_STA);
  const int nb = WiFi.scanNetworks();
  int meilleur = -127;
  for (int i = 0; i < nb; i++)
    if (WiFi.RSSI(i) > meilleur) meilleur = WiFi.RSSI(i);
  WiFi.scanDelete();
  if (Reseau::modePointAcces()) WiFi.mode(WIFI_AP);
  verdict(
      nb > 0, "wifi",
      nb > 0 ? String(nb) + " reseau(x), meilleur signal " + String(meilleur) + " dBm" : "aucun reseau vu");

  verdict(true, "heure", heureFiable() ? horodatage() : "inconnue (normal sans reseau)");
  verdict(Courant::actif() || !INA219_ACTIF, "INA219",
          Courant::actif() ? String(Courant::lireMaintenant(), 2) + " A au repos" : "absent");

  if (puissance) {
    for (uint8_t i = 0; i < NB_TAPIS; i++) {
      digitalWrite(PIN_TAPIS[i], HIGH);
      delay(300);
      const float a = Courant::lireMaintenant();
      digitalWrite(PIN_TAPIS[i], LOW);
      delay(200);
      const bool ok = Courant::actif() ? (a > 0.3f) : true;
      verdict(ok, "MOSFET",
              "tapis " + String(i + 1) + " : impulsion 300 ms" +
                  (Courant::actif() ? ", " + String(a, 2) + " A"
                                    : " (sans INA219 : verifier a la LED ou au voltmetre)"));
    }
  } else {
    Serial.println(
        F("  [ -- ] MOSFET         non actionnes (`test usine oui` pour une impulsion de 300 ms par tapis)"));
  }
  Serial.printf("=== TEST USINE : %s (%u echec(s)) ===\n\n", echecs ? "ECHEC" : "OK", echecs);
}

}  // namespace Console
