NoeMrct/terrarium_thermostat/page_web_gz.h

/* page_web_gz.h — GÉNÉRÉ par `node outils/compresser-page.js` à partir de page_web.h.
   Ne pas éditer à la main : modifier page_web.h, puis relancer le script.

   La page est stockée compressée (gzip) et servie telle quelle avec
   « Content-Encoding: gzip » : tous les navigateurs la décompressent.
   47188 octets en clair, 16207 compressés. */
#ifndef PAGE_WEB_GZ_H
#define PAGE_WEB_GZ_H

#include <Arduino.h>

#define PAGE_HTML_GZ_LEN 16207
static const uint8_t PAGE_HTML_GZ[PAGE_HTML_GZ_LEN] PROGMEM = {
  0x1f,0x8b,0x08,0x00,0x00,0x00,0x00,0x00,0x02,0x03,0xcd,0xbd,0xdb,0x72,0xdb,0x48,0xb6,0x20,0xfa,0xae,0xaf,0x48,0xd3,0xd5,
  0x06,0xd0,0x04,0x21,0x80,0x94,0x28,0x89,0x14,0xa8,0xa3,0xb2,0x5d,0xe5,0xaa,0xb6,0xab,0x3c,0x96,0xeb,0xd2,0x76,0x7b,0x9f,
  0x4a,0x02,0x09,0x32,0x2d,0x10,0xa0,0x81,0x04,0x45,0x8b,0xe2,0x44,0xc7,0x3c,0x9c,0x88,0x79,0x3d,0x31,0x1f,0xd0,0x71,0x1e,
  0xf6,0x6c,0xed,0x3d,0x71,0x62,0x3f,0x4c,0xc4,0x3c,0xd4,0x5b,0xe9,0xfd,0x7c,0x44,0x7f,0xc9,0x89,0xb5,0x32,0x71,0xe3,0xcd,
  0x72,0xef,0xe9,0x3d,0x53,0x15,0x61,0x11,0x89,0xc4,0xca,0xcc,0x95,0x2b,0x57,0xae,0x5c,0xb7,0x3c,0x7d,0xe0,0xc7,0x9e,0xf8,
  0x38,0x65,0x64,0x2c,0x26,0xe1,0xe0,0x14,0xfe,0x25,0x21,0x8d,0x46,0x6e,0x23,0x48,0x1a,0x83,0xd3,0x31,0xa3,0xfe,0x60,0xef,
  0x74,0xc2,0x04,0x25,0xde,0x98,0x26,0x29,0x13,0x6e,0x23,0x13,0x41,0xeb,0xb8,0x31,0x90,0xa5,0x11,0x9d,0x30,0xb7,0x31,0xe3,
  0xec,0x6a,0x1a,0x27,0xa2,0x41,0xbc,0x38,0x12,0x2c,0x12,0x6e,0xe3,0x8a,0xfb,0x62,0xec,0xfa,0x6c,0xc6,0x3d,0xd6,0xc2,0x07,
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
  0x74,0xb6,0xa1,0x23,0xf9,0x44,0xd9,0xc4,0x01,0x54,0x0d,0xe3,0xc4,0x67,0x49,0x2b,0xa1,0x3e,0xcf,0x52,0xd9,0xfb,0xb5,0x39,
  0xa3,0xf5,0x39,0xa3,0xc2,0x28,0x86,0x23,0x51,0xdc,0xda,0xd6,0xd1,0x4a,0x07,0x1d,0xeb,0xf0,0xd3,0x28,0xb6,0xec,0x03,0x36,
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
};

#endif // PAGE_WEB_GZ_H
