NoeMrct/terrarium_thermostat/page_wifi_gz.h

/* page_wifi_gz.h — GÉNÉRÉ par `node outils/compresser-page.js` à partir de page_wifi.h.
   Ne pas éditer à la main : modifier page_wifi.h, puis relancer le script.

   La page est stockée compressée (gzip) et servie telle quelle avec
   « Content-Encoding: gzip » : tous les navigateurs la décompressent.
   7797 octets en clair, 3548 compressés. */
#ifndef PAGE_WIFI_GZ_H
#define PAGE_WIFI_GZ_H

#include <Arduino.h>

#define PAGE_WIFI_GZ_LEN 3548
static const uint8_t PAGE_WIFI_GZ[PAGE_WIFI_GZ_LEN] PROGMEM = {
  0x1f,0x8b,0x08,0x00,0x00,0x00,0x00,0x00,0x02,0x03,0xad,0x59,0xcd,0x92,0xdc,0xb6,0x76,0xde,0xf7,0x53,0xc0,0x9c,0x9b,0x8b,
  0xa6,0xa7,0xc9,0xfe,0x9b,0x19,0x8d,0xc9,0x26,0x15,0x5d,0xe5,0x26,0x72,0x95,0x7f,0x6e,0x49,0xf2,0x4d,0xaa,0x54,0x5a,0x80,
  0xc4,0x61,0x37,0x34,0x20,0x40,0x03,0x60,0x4f,0x8f,0x5b,0x5d,0xa5,0x65,0xd6,0xa9,0x6c,0xbc,0xcb,0xea,0x96,0xa7,0xf2,0x00,
  0xa9,0x54,0x76,0x9e,0x37,0xd1,0x93,0x24,0x00,0xc9,0x1e,0x76,0xcf,0xd8,0xd2,0x22,0x0b,0x8f,0x49,0x34,0x08,0x7c,0xe7,0x7c,
  0xdf,0xf9,0x01,0xb4,0xf8,0x82,0xca,0xdc,0xdc,0x54,0x80,0x56,0xa6,0xe4,0xe9,0xc2,0xfe,0x45,0x9c,0x88,0x65,0xe2,0x15,0xca,
  0x4b,0x17,0x2b,0x20,0x34,0x1d,0x2c,0x4a,0x30,0x04,0xe5,0x2b,0xa2,0x34,0x98,0xc4,0xab,0x4d,0x11,0x5c,0x7a,0x69,0x33,0x2a,
  0x48,0x09,0x89,0xb7,0x66,0x70,0x5d,0x49,0x65,0x3c,0x94,0x4b,0x61,0x40,0x98,0xc4,0xbb,0x66,0xd4,0xac,0x12,0x0a,0x6b,0x96,
  0x43,0xe0,0x5e,0x46,0x4c,0x30,0xc3,0x08,0x0f,0x74,0x4e,0x38,0x24,0x53,0xaf,0x5b,0xb9,0x59,0x23,0x97,0x5c,0xaa,0x40,0xe7,
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
  0x43,0x9b,0x36,0x4a,0x5e,0xc1,0xbd,0x0f,0x9a,0xf7,0xd6,0xd8,0x69,0x78,0xb9,0x1b,0x70,0x92,0x01,0xdf,0xdb,0x96,0x71,0x99,
  0x5f,0xed,0x05,0x7c,0xe9,0xa2,0xe3,0xa2,0x8b,0xb2,0xbd,0xea,0x1f,0x04,0xdd,0x51,0x98,0x0c,0x98,0xa8,0x6a,0xb3,0xcd,0xe4,
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
};

#endif // PAGE_WIFI_GZ_H
