NoeMrct/terrarium_thermostat/affichage.h

/* affichage.h — écran OLED local : température, état, réseau. */
#ifndef AFFICHAGE_H
#define AFFICHAGE_H

#include "config.h"

namespace Affichage {
void demarrer();
bool present();
void rafraichir();
void message(const String &ligne1, const String &ligne2);
void reveiller();  // sort l'écran de veille (activité, défaut, commande)
// Affiche le code d'appairage pendant `secondes` : en QR code à gauche (lisible
// par l'application, caméra du téléphone) et en toutes lettres à droite.
// NE BLOQUE PAS : l'écran est rendu par rafraichir(), la régulation, le réseau
// et la console continuent de tourner pendant ce temps.
void appairage(const char *identifiant, const char *jeton, uint32_t secondes);
bool appairageEnCours();
// Mire de test (plein, puis damier) pendant `ms` ; false sans écran.
bool mire(uint32_t ms);
// Bouton BOOT : page suivante (zones, courbes des 6 dernières heures, réseau,
// sondes, système). Retour aux zones tout seul après 30 s sans appui.
void pageSuivante();
// Avis de quelques secondes, par-dessus les pages (bouton tenu, action faite).
void avis(const String &ligne1, const String &ligne2, uint32_t ms);
}  // namespace Affichage

#endif  // AFFICHAGE_H
