NoeMrct/terrarium_thermostat/essai.cpp

#include "essai.h"
#include "sondes.h"
#include "stockage.h"

namespace {

int8_t g_zone = -1;
uint32_t g_debut = 0;
float g_ref[NB_ZONES];
char g_resultat[220] = "";

void terminer(const char *texte) {
  snprintf(g_resultat, sizeof g_resultat, "%s", texte);
  journal("Essai de chauffe : %s", g_resultat);
  g_zone = -1;
  ctrl.arreterForcage();
}

}  // namespace

namespace Essai {

bool lancer(uint8_t zone, char *message, size_t taille) {
  if (zone >= NB_ZONES) {
    snprintf(message, taille, "Zone invalide");
    return false;
  }
  if (g_zone >= 0) {
    snprintf(message, taille, "Essai deja en cours (zone %d)", g_zone + 1);
    return false;
  }
  if (Sondes::zoneEnIdentification() >= 0) {
    snprintf(message, taille, "Identification de sonde en cours : attendre qu'elle se termine");
    return false;
  }
  if (!isfinite(ctrl.zone[zone].temperature) || ctrl.zone[zone].defaut != DEF_AUCUN) {
    snprintf(message, taille,
             "Zone %u sans mesure valide ou en defaut : `scan`, `identifier %u`, puis `reset`", zone + 1,
             zone + 1);
    return false;
  }
  if (ctrl.zone[zone].temperature >= ctrl.consignePour(zone) + 1.0f) {
    snprintf(message, taille,
             "Zone %u deja au-dessus de sa consigne : essai inutile et risque, attendre qu'elle refroidisse",
             zone + 1);
    return false;
  }
  if (!ctrl.forcerChauffe(zone, millis(), ESSAI_MS)) {
    snprintf(message, taille, "Chauffe impossible maintenant (entretien, mise a jour ou defaut)");
    return false;
  }
  for (uint8_t k = 0; k < NB_ZONES; k++) g_ref[k] = ctrl.zone[k].temperature;
  g_zone = (int8_t)zone;
  g_debut = millis();
  g_resultat[0] = '\0';
  snprintf(
      message, taille,
      "Zone %u : chauffe seule a pleine puissance, verdict des que sa sonde gagne %.1f C (10 min au plus). "
      "Ne pas laisser sans surveillance.",
      zone + 1, (double)ESSAI_HAUSSE);
  journal("Essai de chauffe lance sur la zone %u (%.2f C)", zone + 1, (double)g_ref[zone]);
  return true;
}

void annuler() {
  if (g_zone < 0) return;
  char t[60];
  snprintf(t, sizeof t, "zone %d : essai arrete a la demande", g_zone + 1);
  terminer(t);
}
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
