NoeMrct/terrarium_thermostat/(commit log)

2026-09-14 Socle chauffant : firmware 3.2.0, application, outils et bancs d'essai
    Régulateur de terrarium à deux zones sur ESP32, câblé sur le matériel
    réel : deux tapis 12 V 20 W sur IO16 et IO17, un bilame KSD9700 par
    plaque, carte alimentée par un LM2596 depuis le 12 V, masse en étoile.
    - Firmware : régulation PI avec autotune, ordonnancement par crédits,
    diagnostics, historique LittleFS, MQTT, page web embarquée, OTA.
    - Application web/mobile MQTT et socle simulé pour la démonstration.
    - Bancs d'essai PC (régulation, anneau, formatage), suites de tests du
    protocole, de l'application et de l'interface web, vérification CI.
    - Compilé avec le cœur ESP32 3.3.11 : 1 410 759 octets,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
    [partitions.csv]
2026-09-20 Netlify : publier app/ et ne pas mettre l'agent de service en cache
    Un dépôt importé depuis GitHub publie la racine par défaut, qui ne contient
    aucun index.html : le site répondait « Page not found ». Le netlify.toml fixe
    le dossier à publier, y compris pour les aperçus de branche, là où un réglage
    saisi dans l'interface ne vaut que pour la production.
    L'en-tête no-cache sur sw.js évite qu'un agent de service périmé retarde de
    plusieurs jours l'arrivée d'une correction sur un téléphone.
    Claude-Session: https://claude.ai/code/session_01CCxATSyYRrj3TD59jQGNbk
2026-09-20 Afficher l'identifiant de l'appareil, sans quoi on ne peut pas l'appairer
    L'identifiant « terraA1B2C3 », derive des trois derniers octets de l'adresse
    MAC, n'apparaissait nulle part : ni dans la console, ni sur l'ecran, ni sur la
    page web. Il ne vivait que dans les sujets MQTT et les charges JSON. Or c'est
    la premiere des deux choses que l'application demande pour rattacher un socle,
    et c'est lui qui determine le filtre de sujets a declarer cote broker.
    - Reseau::identifiant() expose g_id, qui n'etait qu'une variable de module.
    - `reseau` et `jeton` l'affichent, `reseau` donnant aussi la racine des sujets.
    - /api/reseau ajoute le champ "appareil", et la carte d'appairage de la page
    web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
    [console.cpp, reseau.cpp, reseau.h]
2026-10-14 Socle chauffant 3.3.0 et 3.4.0 : mise à jour tirée, serveur optionnel, sessions, qualité et documentation
    Firmware 3.4.0 (protocole 3) : mise à jour téléchargée par le socle depuis les
    releases GitHub (origine et redirections bornées, signature, état persistant),
    nouvelle table de partitions (2 × 1,69 Mo, 512 Ko de fichiers), nom d'hôte et
    point d'accès par socle avec portail captif, Improv Wi-Fi, connexion par
    défi/réponse et session, auto-test usine, canal de commandes extrait et
    testé sur PC, réglages à décalages figés, compilation reproductible.
    Inclut tout le lot 3.3.0 (retour arrière OTA, rapport de plantage, santé,
    alertes texte, images signées, QR d'appairage, I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
2026-10-14 CI : corriger la syntaxe YAML des workflows, les conditions sur les secrets, cppcheck et clang-format
    Deux noms d'étape contenaient « : » sans guillemets, ce que GitHub refuse ;
    les secrets ne sont pas lisibles dans un « if » d'étape (ils passent par
    l'environnement du job) ; cppcheck relevait un faux positif dans qr.cpp et
    l'idiome « | false » d'ArduinoJson ; clang-format n'a pas à relire l'en-tête
    généré page_web_gz.h ; l'étape Lighthouse remet les sources minifiées en
    l'état. Vérifié avec actionlint, cppcheck 2.13 et clang-format 18.
    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
2026-10-14 Outils : adopter ESLint 10, TypeScript 7, c8 12 et mqtt 5.16, garder jsdom 24 ; Dependabot sans montées majeures
    La montée de version groupée fusionnée depuis Dependabot cassait la CI :
    ESLint 10 n'embarque plus @eslint/js (ajouté en dépendance) et apporte deux
    règles nouvelles (corrigées : no-useless-assignment, preserve-caught-error),
    et jsdom 30 fait planter le client WebSocket des bancs dans undici. Chaque
    version a été rejouée sur l'ensemble des suites avant d'être retenue. Les
    montées majeures sont désormais exclues des propositions automatiques, et le
    serveur reçoit aussi ses mises à jour groupées. Le dossier cles/ (clés de
    signature, hors dépôt) est ignoré.
    Co-A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
2026-10-14 CI : références visuelles produites par la CI, clang-tidy sans les en-têtes tiers, reproductibilité à cœur constant
    La comparaison pixel à pixel n'a de sens qu'entre captures faites au même
    endroit : un workflow « Références visuelles » (à lancer à la main) les
    régénère sur l'exécuteur GitHub et les commite. clang-tidy relevait des
    diagnostics dans ArduinoJson, désormais inclus comme en-tête système ; le
    fuzzing n'inonde plus le journal. La compilation reproductible compare deux
    compilations du sketch aux mêmes options, avec le cœur ESP32 déjà compilé :
    recompiler le cœur lui-même n'est pas déterministe. Le test en Firefox
    tolère son avertissement CSP sur les Tr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
2026-10-14 Références visuelles régénérées par la CI (5602b22)
2026-11-12 Firmware 3.5.0 : sondes sûres, diagnostic sans câble, rapport et coût, soleil, sauvegarde ; correctifs CI
    - Sondes : liaison stricte par adresse, assistant d'identification, contrôle
    croisé « sondes inversées », filtre des valeurs aberrantes, essai de chauffe
    guidé, calibration côte à côte
    - Façade : bouton BOOT (pages, QR, point d'accès), LED d'état, ligne d'état,
    courbes des 6 dernières heures, écran la nuit
    - Alertes : trop chaud, coupure de courant, redémarrages en série, mémoire
    fragmentée
    - Rapport quotidien, coût en euros, résumés journaliers sur un an, jour et nuit
    calés sur le soleil, zone prioritaire, Wi-Fi de secours, sauvegarde et
    restauratio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
2026-11-12 Références visuelles régénérées par la CI (d89d4f6)
2026-11-12 Application : l'onglet Appareil n'efface plus défauts et autotune
    - La réponse « stats » (qui a aussi un tableau « zones ») était prise pour
    un état : ouvrir l'onglet Appareil effaçait de l'écran un défaut, la
    chauffe et le temps de service jusqu'à la publication suivante. Seule la
    réponse « etat » met désormais l'état à jour.
    - Un drapeau absent garde sa valeur : l'autotune et la dérive ne
    disparaissent plus à chaque publication d'une zone. Le firmware 3.5 publie
    autotune, derive et trop_chaud sur le sujet etat de chaque zone (schéma,
    PROTOCOLE.md, socle simulé et démonstration à jour).
    - Test de bout en bout des deux cas. Ces défauts rendaient aussi la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
2026-11-12 Références visuelles régénérées par la CI (1ba6b06)
2026-11-12 Dependabot une fois par trimestre, sans double vérification
    - Outils, serveur et actions GitHub : un passage par trimestre, une seule
    proposition groupée par écosystème, pas de rebasage automatique (une
    proposition dépassée se reprend par « @dependabot rebase »).
    - La vérification tourne sur main et sur les propositions de fusion, plus
    sur chaque poussée d'une branche qui a déjà une proposition ouverte : les
    propositions de Dependabot ne lançaient pas une mais deux vérifications
    complètes à chaque mise à jour.
    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
2026-11-14 Application et serveur : présence, notifications, ajout de socle, statistiques
    - Présence : un état retenu, rejoué par le broker à l'abonnement, faisait
    passer un socle éteint pour « en ligne ». Seul le sujet statut (et son
    testament) en décide ; un état rejoué n'entre plus dans l'historique local.
    - Notifications par l'agent de service (showNotification) : Chrome sur
    Android refuse new Notification(), elles n'y apparaissaient jamais. Sur
    iPhone hors écran d'accueil, l'application dit qu'il faut l'installer au
    lieu d'accuser le HTTPS.
    - « Tout effacer » supprime aussi la base IndexedDB de l'historique local.
    - Tuiles : plus de débordement entre 320 et 390 px. Le nom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
2026-11-14 Firmware : mot de passe du point d'accès propre à chaque socle
    - Fini le mot de passe commun terrarium1234, imprimé dans la documentation :
    le socle tire le sien (10 caractères, sans i, l, o, 0 ni 1) à la première
    ouverture du point d'accès, radio allumée, et le garde. Un socle resté sur
    l'ancien mot de passe commun en reçoit un nouveau à la prochaine
    ouverture ; un mot de passe choisi est respecté.
    - Affiché sur l'écran : page Réseau (la ligne MQTT lui laisse la place) et,
    en bas de la page principale, en alternance avec « AP config » ; la
    commande série etat le donne aussi.
    - Tirage et règle de renouvellement dans reglages.cpp, testés sur PC
    (make migratio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
2026-11-14 Test en navigateur : notification « trop chaud » vérifiée sans affichage
    Le Chromium sans interface de la CI n'affiche pas les notifications :
    getNotifications() y reste vide alors que l'application appelle bien
    showNotification. Le test note aussi les appels eux-mêmes, et donne l'état
    de la permission en cas d'échec.
    Claude-Session: https://claude.ai/code/session_01EnBsUx3iNG9BNDucwAT3Zd
2026-11-14 Références visuelles régénérées par la CI (e86ae51)
2026-11-14 Test en navigateur : permission de notification simulée en CI
    Le Chromium sans interface de la CI garde la permission « denied » malgré
    grantPermissions : l'application ne tentait donc aucune notification. La
    permission y est simulée pour vérifier le chemin de l'application (appel à
    showNotification de l'agent de service) ; vérifié en local avec et sans
    permission accordée.
    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
2026-11-14 Application : l'anglais chargé à la demande (C2)
    - Le dictionnaire anglais (un quart d'app.js minifié) passe dans
    app/textes.en.js, un module ES importé au démarrage seulement quand la
    langue retenue est l'anglais ; le français reste dans app.js et sert de
    repli clé par clé (hors ligne et fichier absent du cache compris).
    - app.js : 26 022 octets gzip au lieu de 29 974 ; démarrage 39 934 / 44 000.
    budget.js distingue le poids de démarrage des modules à la demande, qui
    ont leur propre budget (textes.en.js : 5 428 / 6 500).
    - L'agent de service le met en cache ; la publication le minifie (module) ;
    la démonstration, ouverte en file://, l'embarque d'avance (TEXTES_EN) ;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
2026-11-14 Firmware et page locale : mot de passe de l'interface obligatoire (S2)
    - Plus d'accès libre par défaut : tant qu'aucun mot de passe n'est défini,
    le socle ne sert que la page, le défi (« libre », « creer ») et la
    création ; toute autre route répond 428 — réglages et code d'appairage
    compris, qui étaient lisibles par n'importe quel appareil du réseau.
    - POST /api/premier-acces : utilisateur + empreinte SHA-256 de
    « utilisateur:mot de passe » calculée par la page (le mot de passe ne
    voyage pas, 8 caractères au moins) ; refusé (409) dès qu'un mot de passe
    existe. La page montre « Créer le mot de passe » puis se connecte seule.
    - Onglet Réseau : l'utilisateur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
2026-11-14 Protocole 4 : commandes signées, le code d'appairage ne circule plus (S3)
    - Enveloppe {"c": "<commande JSON>", "sig": HMAC-SHA256(code, c)} : la
    signature porte sur les octets exacts de c (rien à canonicaliser) ; la
    commande porte "ts", et un socle à l'heure refuse un écart de plus de
    5 min (rejeu borné, en plus de la mémoire des huit dernières requêtes).
    Signature fausse : « signature invalide » avec le bon req, journalisée.
    - Firmware : PROTO_VERSION 4 ; signature.cpp (SHA-256 et HMAC autonomes,
    sans mbedtls, identiques sur le socle et sur PC) ; la commande en clair
    avec "jeton" reste acceptée pour les applications pas encore à jour.
    - Application : signe par WebCr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
2026-11-14 Protocole 4 : à distance, ce que la page locale faisait seule (F1)
    L'application peut désormais, par le canal de commande : inventorier et lier
    les sondes, lancer l'assistant d'identification, un essai de chauffe ou la
    calibration, lire ou envoyer le rapport du jour, lire le journal et les
    résumés journaliers, exporter et restaurer la sauvegarde, régler la
    surveillance (alertes, heartbeat) et les réglages 3.5 de « globaux ».
    Rien de secret ne revient par le broker : tout identifiant Wi-Fi est refusé
    (le Wi-Fi se règle sur la page locale), une adresse d'alerte s'écrit mais
    seul son hôte se relit, et la sauvegarde envoyée par le broker omet ces
    adresses (restaurée, elle garde ce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
2026-11-14 Application : onglet Service et réglages 3.5 à distance (F1)
    Nouvel onglet Service, pour les socles en firmware 3.5 (protocole 4) :
    sondes (inventaire, liaison à une zone, identification suivie en direct),
    essai de chauffe et calibration avec confirmation, rapport du jour,
    journal, résumés journaliers en tableau, alertes et surveillance, et
    sauvegarde du socle à télécharger ou restaurer.
    Rien de secret ne s'affiche : seul le serveur des adresses d'alerte et de
    heartbeat apparaît, et une adresse enregistrée quitte aussitôt son champ.
    Le Wi-Fi reste réglable sur la page locale seulement.
    L'onglet est un module à part (app/service.js, 6 Ko compressés), importé à
    sa première o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
2026-11-14 Références visuelles régénérées par la CI (e586cbf)
2026-11-14 Application redessinée d'après les maquettes (I12)
    Fond blanc, grands chiffres fins (Inter, licence OFL, hébergée avec
    l'application), noir pour les commandes, orange et bleu réservés aux deux
    zones ; le thème sombre automatique est conservé.
    - Accueil d'un socle : le terrarium dessiné de trois quarts (SVG), dont les
    zones s'éclairent quand elles chauffent et se cerclent de rouge en défaut ;
    une ligne d'état (« Tout va bien · jour jusqu'à 20:00 ») ; les deux zones
    en grand ; quatre boutons ronds (Entretien, Lever les défauts, Alertes,
    Mises à jour) ; huit rubriques qui s'ouvrent en feuilles : Températures,
    Programmation, Courbes, Alertes, Sécurité, Appareil, S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
2026-11-14 Références visuelles régénérées par la CI (3fc81ad)
2026-11-14 CI : virgule décimale dans test-serveur, police sans préchargement
    La liste des socles affiche désormais 30,5 en français : test-serveur
    cherchait « 30.5 » et concluait que les températures n'arrivaient pas.
    Firefox signalait le préchargement de la police comme « inutilisé » quand
    l'agent de service servait la page, ce que le test navigateur compte comme
    un avertissement. La feuille de style, chargée en tête, découvre la police
    aussitôt : le préchargement est retiré (et la démo n'a plus à l'enlever).
    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
2026-11-14 Installation guidée d'un socle : accueil, étiquette à lien, Wi-Fi suivi, portail captif
    Application
    - Écran d'accueil au premier lancement : se connecter à son serveur, essayer
    la démo, ou « chez moi seulement » (la page locale du socle). « Changer de
    broker » mène droit au formulaire.
    - Assistant d'installation (bouton +), d'après les maquettes : l'étiquette
    (scan, ou référence et code), le Wi-Fi (réseau du socle nommé comme le
    firmware le nomme, puis suivi en direct : Wi-Fi rejoint et signal, serveur
    joint, heure réglée, code vérifié ; avec le serveur Terrariums, c'est le
    rattachement qui prouve le code), les réglages de départ (nom, consignes et
    noms d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
2026-11-14 Références visuelles régénérées par la CI (9cd8f01)
2026-11-14 Page locale aux couleurs de l'application (I7)
    Même langage visuel que l'application et le portail captif : fond blanc,
    cartes grises sans ombre, commandes noires en pilule, onglets segmentés,
    orange et bleu pour les zones, et le sombre automatique. Les températures
    s'affichent en grands chiffres fins, à une décimale et à la française
    (« 30,6° »), avec « CHAUFFE · cible 32,0° » dans la couleur de la zone. Un
    bandeau « PAGE LOCALE · sans Internet » dit d'emblée où l'on est. Les
    couleurs du graphique viennent de la feuille de style (clair ou sombre).
    page_web_gz.h : 16 207 octets compressés (+295).
    Claude-Session: ht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
2026-11-14 Atelier : monter les socles en série, du flashage à l'étiquette
    Nouvelle page atelier.html (Chrome ou Edge sur ordinateur, port série du
    navigateur) qui suit chaque socle en cinq étapes, avec un registre par lot :
    1. Console (USB, 12 V débranché) : jeton et version, test usine, mot de
    passe de la page locale tiré dans le navigateur, Wi-Fi du banc, compte
    d'appareil sur le serveur Terrariums ou broker de l'atelier.
    2. Sondes (12 V, par le broker, commandes signées) : identification à la
    main de chaque zone.
    3. Chauffe : essai de chaque tapis, verdict du socle.
    4. Rodage (24 h réglables) : coupures, défauts et redémarrages notés ; le
    verdict s'appuie sur la durée de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
2026-11-14 Tests : le contrôle de débordement nomme ce qui dépasse
    À 320 px, WebKit voit la feuille Appareil plus large que l'écran sans
    qu'aucune tuile ne déborde. Le contrôle liste désormais les éléments les
    plus profonds qui dépassent (balise, classes, position, début du texte) et
    la largeur réelle de la page, pour corriger sans deviner.
    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
2026-11-14 Tests : le contrôle de débordement situe aussi un texte qui dépasse
    Quand aucune boîte ne dépasse (WebKit à 320 px : page de 330 px), le
    contrôle descend jusqu'au conteneur le plus profond dont la largeur
    défilable dépasse l'écran et en donne le style (white-space,
    overflow-wrap) et le texte.
    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
2026-11-14 Tests : chercher ce qui empiète sur la marge de <main> à 320 px
    WebKit compte la marge intérieure de fin de <main> dans la largeur
    défilable de la page : un élément qui empiète sur elle suffit à faire
    déborder la page, même s'il reste dans l'écran. Le diagnostic liste les
    éléments qui dépassent la boîte de contenu de <main>, avec leur largeur
    et leur style, sur des lignes à part (le détail du contrôle est tronqué).
    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
